asiggel/rwu-rv64iV2.0/RWU_RV/RV_NoPipeline/spec/02_prod/02_product_text14.tex

The \aschip{} implements the RISC-V \textbf{machine-mode-only} interrupt and
trap concept of the privileged specification. Both chip variants use the
same trap/CSR unit \texttt{cc\_trap\_csr} from \texttt{ip\_trapcsr/src}.
It is instantiated as \texttt{trap\_csr} in the cores \texttt{as\_cpux}
(\texttt{RV\_NoPipeline}) and \texttt{cc\_cpupipefwd}
(\texttt{RV\_PipelineCacheFwd}). The core decides \emph{when} a trap is
taken (its precise-trap point, see below); \texttt{cc\_trap\_csr} holds the
architectural state and decides \emph{what} happens.

All three standard machine interrupts are supported:
\begin{itemize}
  \item \textbf{Machine External Interrupt} (MEI, \texttt{mcause}\,=\,\texttt{0x800...B}):
    from ICU0 via \texttt{irq\_ext\_i[7]}.
  \item \textbf{Machine Software Interrupt} (MSI, \texttt{mcause}\,=\,\texttt{0x800...3}):
    CPU input \texttt{irq\_m\_soft\_i}, intended for the \texttt{msip} bit of
    a CLINT.
  \item \textbf{Machine Timer Interrupt} (MTI, \texttt{mcause}\,=\,\texttt{0x800...7}):
    CPU input \texttt{irq\_m\_timer\_i}, intended for the \texttt{mtip}
    output (\texttt{mtime}\,$\geq$\,\texttt{mtimecmp}) of a CLINT.
\end{itemize}
No CLINT exists on the chip yet; in both variants \texttt{as\_top\_mem}
ties the inputs \texttt{irq\_m\_soft\_i} and \texttt{irq\_m\_timer\_i} to 0.
A CLINT only has to drive these two level signals.

\paragraph{Peripheral-to-CPU path.}
The top level (\texttt{as\_top\_mem}) presents an 8-bit vector,
\texttt{irq\_ext\_i} (\texttt{irq\_total\_num\_ext\_c}\,=\,8), to the CPU.
Of these 8 bits, \textbf{only bit~7 is wired into the CPU's interrupt
logic}: \texttt{cc\_trap\_csr} synchronises it (like
\texttt{irq\_m\_soft\_i} and \texttt{irq\_m\_timer\_i}) through a
2-flip-flop synchroniser and shows the result as \texttt{mip.MEIP}.
Bits~\texttt{[6:0]} are declared but not consumed.
Bit~7 is driven by \textbf{ICU0} (Section~\ref{sec:icufunc01}), a
Wishbone-addressable interrupt controller that aggregates GPIO0, UART0,
and (on \texttt{RV\_PipelineCacheFwd}) QSPI0 with software-configurable
priority and per-source masking, plus 5 further source slots reserved for
future peripherals (Table~\ref{tab:asIcuSrcAssign}). GPIO0's own interrupt
chain (per-pin change detection $\rightarrow$ \texttt{IRQSS}/\texttt{IRQSM}
$\rightarrow$ single-bit \texttt{RIS[0]} $\rightarrow$ \texttt{IMSC[0]}
$\rightarrow$ \texttt{MIS[0]} $=$ \texttt{gpio\_irq\_o}) collapses all GPIO
pins onto one line before it ever reaches ICU0; see
Section~\ref{sec:gpiofunc01} for the full GPIO0 register description.

\paragraph{Machine-mode CSRs.}
Table~\ref{tab:asTrapCsr} lists the CSRs of \texttt{cc\_trap\_csr}. Every
other CSR address raises an illegal-instruction exception, as does a write
to a read-only CSR (\texttt{csr[11:10]}\,=\,\texttt{11}).
\texttt{csrrs}/\texttt{csrrc} (and the immediate forms) with
\texttt{rs1}\,=\,\texttt{x0} (\texttt{uimm}\,=\,0) only read; they do not
write the CSR. Bits that are not listed as writable are WARL: writes are
ignored and they read as the fixed value given.

\begin{table}[htbp]
\caption{Machine-mode CSRs (\texttt{cc\_trap\_csr})}
\label{tab:asTrapCsr}
\centering
{\footnotesize
\begin{tabularx}{\textwidth}{|p{1.6cm} |p{2.1cm} |p{1.5cm} |X |}
  \hline
  Addr. & Name & Reset & Function / WARL rule \\
  \hline
  \hline
  0x300 & \texttt{mstatus}   & 0x1800 & Only \texttt{MIE}[3] and \texttt{MPIE}[7] writable;
    \texttt{MPP}[12:11]\,=\,11 fixed (M-mode only). \texttt{MIE}\,=\,0 after reset. \\
  \hline
  0x301 & \texttt{misa}      & fixed & Read-only 0x8000\_0000\_0000\_0100: MXL\,=\,2 (64 bit), extension I. \\
  \hline
  0x304 & \texttt{mie}       & 0 & \texttt{MSIE}[3], \texttt{MTIE}[7], \texttt{MEIE}[11] writable. \\
  \hline
  0x305 & \texttt{mtvec}     & 0x7F00 & \texttt{BASE}[63:2]; \texttt{MODE}[0]: 0 = direct,
    1 = vectored; \texttt{MODE}[1]\,=\,0 fixed. \\
  \hline
  0x340 & \texttt{mscratch}  & 0 & 64-bit scratch register for the trap handler. \\
  \hline
  0x341 & \texttt{mepc}      & 0 & \texttt{mepc}[1:0]\,=\,0 fixed (IALIGN\,=\,32). \\
  \hline
  0x342 & \texttt{mcause}    & 0 & Interrupt bit [63] and cause code [3:0] stored (WLRL). \\
  \hline
  0x343 & \texttt{mtval}     & 0 & Faulting address or instruction, see Table~\ref{tab:asTrapCause}. \\
  \hline
  0x344 & \texttt{mip}       & 0 & Read-only levels \texttt{MSIP}[3], \texttt{MTIP}[7],
    \texttt{MEIP}[11] of the synchronised inputs. \\
  \hline
  0xB00 & \texttt{mcycle}    & 0 & Counts every core clock cycle; writable. \\
  \hline
  0xB02 & \texttt{minstret}  & 0 & Counts retired instructions (not trapping ones); writable. \\
  \hline
  0xC00\newline 0xC02 & \texttt{cycle}\newline \texttt{instret} & -- & Read-only shadows of
    \texttt{mcycle}/\texttt{minstret}. \\
  \hline
  0xF11\newline 0xF12\newline 0xF13 & \texttt{mvendorid}\newline \texttt{marchid}\newline \texttt{mimpid} & 0 & Read-only. \\
  \hline
  0xF14 & \texttt{mhartid}   & param. & Read-only; core parameter \texttt{HART\_ID}
    (default 0). \\
  \hline
  0xF15 & \texttt{mconfigptr} & 0 & Read-only. \\
  \hline
\end{tabularx}}
\end{table}

\paragraph{Taking an interrupt.}
\begin{itemize}
  \item An interrupt is \emph{pending and enabled} when
    \texttt{mip}\,\&\,\texttt{mie}\,$\neq$\,0, and it is taken only if
    \texttt{mstatus.MIE}\,=\,1.
  \item If several are pending, the priority is MEI $>$ MSI $>$ MTI.
  \item All three are level-sensitive: \texttt{mip} follows the input
    lines and cannot be changed by software. The handler must remove the
    cause at its source (ICU0\_ICR and the peripheral's clear register;
    CLINT \texttt{msip}/\texttt{mtimecmp}) before \texttt{mret}, or the
    interrupt is taken again immediately.
  \item Target address: \texttt{mtvec.BASE} in direct mode; in vectored mode
    \texttt{BASE}\,+\,4\,$\times$\,cause for interrupts (MSI: +0x0C,
    MTI: +0x1C, MEI: +0x2C) and \texttt{BASE} for exceptions.
\end{itemize}

\paragraph{Precise traps.}
A trap is \emph{precise}: \texttt{mepc} points to an instruction such that
every older instruction has completed and neither this instruction nor any
younger one has changed a register, a CSR or memory.
\begin{itemize}
  \item An \textbf{exception} is taken on the faulting instruction:
    \texttt{mepc} = its own address. The instruction is suppressed: no
    register write, no CSR write, and a load/store does \emph{not} access
    memory.
  \item An \textbf{interrupt} is taken between two instructions:
    \texttt{mepc} = address of the first instruction that has not been
    executed (also directly after a taken branch or jump: then it is the
    branch target).
  \item \texttt{RV\_NoPipeline}: exceptions are detected in
    \texttt{EXEC\_ST}/\texttt{EXECLD\_ST}; the store write enable and the
    register write are suppressed. Interrupts, exceptions and
    \texttt{mret} redirect the fetch in the following \texttt{FETCH0\_ST},
    before the next instruction is fetched, so no wrong-path instruction
    ever enters IR. The address of the next instruction in program order is
    registered at commit (\texttt{npc\_r}).
  \item \texttt{RV\_PipelineCacheFwd}: misaligned loads/stores and
    misaligned branch/jump targets are detected in EX and, like illegal
    instructions and I-/D-cache faults, carried as flags to WB, where the
    trap is taken. A load/store with an exception sends no
    \texttt{dc\_req}, and no younger instruction in MEM sends
    \texttt{dc\_req} in the cycle WB traps or returns. An interrupt is
    taken on the instruction in WB before it commits (it is squashed,
    \texttt{mepc} = its address), except for a load/store, whose memory
    access in MEM has already happened: it commits, and the interrupt is
    taken on the next instruction that reaches WB.
\end{itemize}

\paragraph{Trap entry and return.}
On trap entry \texttt{mepc} $\leftarrow$ trap PC, \texttt{mcause} and
\texttt{mtval} $\leftarrow$ Table~\ref{tab:asTrapCause},
\texttt{mstatus.MPIE} $\leftarrow$ \texttt{mstatus.MIE},
\texttt{mstatus.MIE} $\leftarrow$ 0, PC $\leftarrow$ trap target.
\texttt{mret} sets PC $\leftarrow$ \texttt{mepc},
\texttt{mstatus.MIE} $\leftarrow$ \texttt{mstatus.MPIE},
\texttt{mstatus.MPIE} $\leftarrow$ 1. A handler that saves \texttt{mepc}
and \texttt{mcause} (e.g.\ via \texttt{mscratch}) may set
\texttt{mstatus.MIE} again to allow nested interrupts.

\begin{table}[htbp]
\caption{Trap causes}
\label{tab:asTrapCause}
\centering
{\footnotesize
\begin{tabularx}{\textwidth}{|l |X |X |}
  \hline
  \texttt{mcause} & Cause & \texttt{mtval} \\
  \hline
  \hline
  0 & Instruction address misaligned (taken branch/jump to an address with
      bit 1 set; JALR clears bit 0 first) & target address \\
  \hline
  1 & Instruction access fault (I-cache AXI4 error, \texttt{RV\_PipelineCacheFwd}) & fetch address \\
  \hline
  2 & Illegal instruction (decoder, unknown CSR, write to read-only CSR,
      reserved \texttt{SYSTEM} encoding) & instruction bits \\
  \hline
  3 & Breakpoint (\texttt{ebreak}) & 0 \\
  \hline
  4 / 6 & Load / store address misaligned & access address \\
  \hline
  5 & Load access fault (D-cache AXI4 error, \texttt{RV\_PipelineCacheFwd}) & access address \\
  \hline
  11 & Environment call from M-mode (\texttt{ecall}) & 0 \\
  \hline
  \hline
  0x800\ldots3 / 7 / B & Machine software / timer / external interrupt & 0 \\
  \hline
\end{tabularx}}
\end{table}

\texttt{ecall} and \texttt{ebreak} have no side effect beyond the trap;
\texttt{mepc} points at the instruction itself, so the handler has to add 4
before \texttt{mret} to continue after it.

\paragraph{WFI.}
In \texttt{RV\_NoPipeline}, \texttt{wfi} stays in \texttt{EXEC\_ST} until an
interrupt is pending and enabled in \texttt{mie} (independent of
\texttt{mstatus.MIE}); then it completes, and if \texttt{mstatus.MIE}\,=\,1
the interrupt is taken with \texttt{mepc} = address after \texttt{wfi}.
In \texttt{RV\_PipelineCacheFwd}, \texttt{wfi} is executed as a NOP, which
the privileged specification allows.

\paragraph{Verification.}
\texttt{ip\_trapcsr/tb/cc\_trap\_csr\_tb.sv} checks the unit alone (reset
values, legality, WARL, priority, vectoring, counters).
\texttt{cocotb/test\_traps.py} of both variants (shared bodies in
\texttt{RV\_NoPipeline/cocotb/trap\_tests.py}) interrupts programs at random
points and checks that no instruction is lost or repeated (also around
jumps and memory read-modify-write sequences) and that every \texttt{mepc}
is the first unexecuted instruction; it also checks every exception cause,
\texttt{mtval}, the suppression of the trapping instruction, vectored
\texttt{mtvec} and \texttt{wfi}.

\paragraph{Open items.}
\begin{itemize}
  \item A CLINT (\texttt{mtime}, \texttt{mtimecmp}, \texttt{msip}) is not
    yet on the chip; the CPU inputs are ready for it. The \texttt{time}
    CSR (0xC01) is not implemented and traps as illegal.
  \item \texttt{mcountinhibit} is not implemented (illegal).
  \item ICU0 provisions 8 source slots but only 3 are wired to real
    hardware (GPIO0, UART0, and -- \texttt{RV\_PipelineCacheFwd} only --
    QSPI0); connecting a future interrupt-capable peripheral only requires
    wiring it into one of the 5 remaining slots
    (Table~\ref{tab:asIcuSrcAssign}). All ICU0 sources share MEI
    (cause 11), so per-source dispatch uses ICU0\_IRQID in software.
\end{itemize}
