asiggel/rwu-rv64iV2.0/RWU_RV/RV_NoPipeline/spec/05_gpio/05_gpio_tab06.tex

Table \ref{tab:asGpioPer06} shows the input and outputs of the GPIO Top.
\begin{table}[H]
\caption{GPIO Top I/O}
\label{tab:asGpioPer06}
\centering
\begin{tabularx}{\textwidth}{|l |l |l |X|}
  \hline
  Pin & Direction & Width & Explanation \\
  \hline
  \hline
  clk\_i & in & 1 & System clock \\
  \hline
  rst\_i & in & 1 & System reset. Active high. \\
  \hline
  wbdAddr\_i(3:0) & in & 4 &  From WB-Bus. Peripherals addresses. \\
  \hline
  wbdDat\_i(63:0) & in & 64 &  From WB-Bus. Peripherals data input. \\
  \hline
  wbdDat\_o(63:0) & out & 64 &  To WB-Bus. Peripherals data output. \\
  \hline
  wbdWe\_i & in & 1 &  From WB-Bus. Peripherals write enable. \\
  \hline
  wbdSel\_i(7:0) & in & 8 &  From WB-Bus. Peripherals byte select. \\
  \hline
  wbdStb\_i & in & 1 &  From WB-Bus. Valid bus cycle.  \\
  \hline
  wbdAck\_o & out & 1 &  To WB-Bus. Error free bus transaction.  \\
  \hline
  wbdCyc\_i & in & 1 &  From WB-Bus. High for complete bus cycle.  \\
  \hline
  gpio\_irq\_o & out & 1 &  GPIO interrupt. \\
  \hline
  gpio\_o(7:0) & out & 8 &  To chip pins. GPIO outputs for one block. \\
  \hline
  cs\_o & out & 1 &  To chip pins. Chip select for outside GPIO blocks.   \\
  \hline
\end{tabularx}
\end{table}

Table \ref{tab:asGpioPer06a} shows the internals  of the GPIO Top.
\begin{table}[H]
\caption{GPIO Top Signals}
\label{tab:asGpioPer06a}
\centering
\begin{tabularx}{\textwidth}{|l |l |X|}
  \hline
  Signal & Width & Explanation \\
  \hline
  \hline
  irq\_s  & 8 & One-clock-cycle pulses from the GPIO kernel, one per pin (edge detected). Connected to irq\_same\_i of gpioIrq. \\
  \hline
  gpioIrq & -- & Instance of the shared interrupt register block \texttt{as\_irq\_peripheral} (\texttt{ip\_irqper}) with irqs\_yes\_no\,=\,1, nr\_same\_irqs\,=\,8, nr\_other\_irqs\,=\,1 (input tied to 0). It implements all interrupt registers below, see Section ``Interrupt Registers''. \\
  \hline
  irq\_dataob\_s  & 64 & Read data of gpioIrq. Selected by the read multiplexer for all addresses not belonging to ID, DIR or DATA. \\
  \hline
  \asgpioIRQSSRegInt  & 64 & GPIO Interrupt Request Source Status Register \asgpioIRQSSRegExt. Sticky: irqss\_r\,$\leftarrow$\,(irqss\_r \& \textasciitilde clear) | irq\_s. A new pulse is never lost; bits are cleared individually via \asgpioIRQSCRegExt. \\
  \hline
  \asgpioIRQSCRegInt  & 1 & Write strobe of the GPIO Interrupt Request Source Clear Register \asgpioIRQSCRegExt. Not stored: in the write cycle every bit written as '1' clears the corresponding \asgpioIRQSSRegExt bit; 0 - No change. Reading returns 0. \\
  \hline
  \asgpioIRQSMRegInt  & 64 & GPIO Interrupt Request Source Mask Register \asgpioIRQSMRegExt.  One interrupt request source mask bit is provided for
each interrupt request source: 0 - Interrupt Request Source Disabled, 1 - Interrupt Request Source Enabled. \\
  \hline
  irq\_same\_comb\_s  & 1 & |(\asgpioIRQSSRegInt \& \asgpioIRQSMRegInt): OR of all unmasked pending pin interrupts. Drives RIS[0] as a level. \\
  \hline
  \asgpioRISRegInt  & 64 & GPIO Raw Interrupt Status \asgpioRISRegExt = ris\_r | irq\_same\_comb\_s (bit 0). ris\_r is sticky, set by \asgpioISRRegExt, cleared by \asgpioICRRegExt. 0 - No Interrupt, 1 - Interrupt Pending. \\
  \hline
  \asgpioISRRegInt  & 1 & Write strobe of the GPIO Interrupt Set Register \asgpioISRRegExt. Not stored: writing a '1' sets the corresponding \asgpioRISRegExt bit (and MIS if IMSC = 1).  0 - No change. Reading returns 0. \\
  \hline
  \asgpioICRRegInt  & 1 & Write strobe of the GPIO Interrupt Clear Register \asgpioICRRegExt. Not stored: writing a '1' clears the corresponding ISR-forced \asgpioRISRegExt bit.  0 - No change. Reading returns 0. \\
  \hline
  \asgpioIMSCRegInt  & 64 & GPIO Interrupt Mask Control Register \asgpioIMSCRegExt. One interrupt mask bit is provided for each service request: 0 - Interrupt Disabled, 1 - Interrupt Enabled. \\
  \hline
  \asgpioMISRegInt  & 64 & GPIO Masked Interrupt Status \asgpioMISRegExt = \asgpioRISRegExt \& \asgpioIMSCRegExt (combinatorial). gpio\_irq\_o = |\asgpioMISRegExt. \\
  \hline
  \asgpioIDRegInt  & 64 & GPIO ID Register \asgpioIDRegExt. \\
  \hline
  \asgpioDirRegInt  & 64 & GPIO Direction Register \asgpioDirRegExt. \\
  \hline
  \asgpioDatRegInt  & 64 & GPIO Data Register \asgpioDatRegExt. If the direction is input, the values from the pad will be written to the register. If the direction is output, the values from the bus will be written to the register. \\
  \hline
\end{tabularx}
\end{table}
