asiggel/rwu-rv64iV2.0/RWU_RV/RV_NoPipeline/spec/05_imem/05_imem_tab06.tex

% Placeholder for the I-Mem Top I/O table (not included, see 00_rwurv64i_all.tex).
% The former content was a stale copy of the GPIO Top tables; the current GPIO
% description is in 05_gpio/05_gpio_tab06.tex.
