asiggel/rwu-rv64iV2.0/RWU_RV/RV_NoPipeline/spec/00_rwurv64i_top.tex

%%%%%%%%%%%%%%%%%%%%%%%%%%%%%%%%%%%%%%%%%%
% Englisch
%%%%%%%%%%%%%%%%%%%%%%%%%%%%%%%%%%%%%%%%%%
\documentclass[a4paper,12pt]{book}
\usepackage[english]{babel}
\selectlanguage{english}
%%%%%%%%%%%%%%%%%%%%%%%%%%%%%%%%%%%%%%%%%%
% Deutsch
%%%%%%%%%%%%%%%%%%%%%%%%%%%%%%%%%%%%%%%%%%
%\documentclass[a4paper,12pt]{book} 
%\usepackage[german,ngerman]{babel} %Chapter -> Kapitel
%\usepackage[T1]{fontenc}           %Umlaute
%\selectlanguage{ngerman}
%%%%%%%%%%%%%%%%%%%%%%%%%%%%%%%%%%%%%%%%%%

%%%%%%%%%%%%%%%%%%%%%%%%%%%%%%%%%%%%%%%%%%
% Pfade %%%%%%%%%%%%%%%%%%%%%%%%%%%%%%%%%%
%\newcommand{\ASROOT}{/media/andreas/arbeit/neuestruktur/hs_vorlesungen/}
%\newcommand{\UMGEBUNG}{\ASROOT latex/}
\newcommand{\UMGEBUNG}{./}
\newcommand{\BILDERa}{./}
\newcommand{\TEXTa}{./}
\newcommand{\TEXTprod}{./02_prod/}
\newcommand{\TEXTarch}{./03_arch/}
\newcommand{\TEXTalu}{./04_alu/}
\newcommand{\TEXTdec}{./04_dec/}
\newcommand{\TEXTmems}{./04_memsyst/}
\newcommand{\TEXTgpio}{./05_gpio/}
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
\newcommand{\asgpioIDRegExt}{\textbf{GPIO0\_ID}\,}

% CGU
\newcommand{\ascguIDRegInt}{id\_reg\_s\,}
\newcommand{\ascguIDRegExt}{\textbf{CGU\_ID}\,}

% QSPI
\newcommand{\asqspiCtrlRegInt}{ctrl\_reg\_s }
\newcommand{\asqspiCtrlRegExt}{\textbf{QSPI0\_CTRL}\,}
\newcommand{\asqspiCmdRegInt}{cmd\_reg\_s\,}
\newcommand{\asqspiCmdRegExt}{\textbf{QSPI0\_CMD}\,}
\newcommand{\asqspiAddrRegInt}{addr\_reg\_s\,}
\newcommand{\asqspiAddrRegExt}{\textbf{QSPI0\_ADDR}\,}
\newcommand{\asqspiLenRegInt}{len\_reg\_s\,}
\newcommand{\asqspiLenRegExt}{\textbf{QSPI0\_LEN}\,}
\newcommand{\asqspiDummyRegInt}{dummy\_reg\_s\,}
\newcommand{\asqspiDummyRegExt}{\textbf{QSPI0\_DUMMY}\,}
\newcommand{\asqspiStatusRegInt}{status\_reg\_s\,}
\newcommand{\asqspiStatusRegExt}{\textbf{QSPI0\_STATUS}\,}
\newcommand{\asqspiTxdataRegInt}{txdata\_reg\_s\,}
\newcommand{\asqspiTxdataRegExt}{\textbf{QSPI0\_TXDATA}\,}
\newcommand{\asqspiRxdataRegInt}{rxdata\_reg\_s\,}
\newcommand{\asqspiRxdataRegExt}{\textbf{QSPI0\_RXDATA}\,}
\newcommand{\asqspiFifostatRegInt}{fifostat\_reg\_s\,}
\newcommand{\asqspiFifostatRegExt}{\textbf{QSPI0\_FIFOSTAT}\,}
\newcommand{\asqspiICRRegInt}{icr\_reg\_s\,}
\newcommand{\asqspiICRRegExt}{\textbf{QSPI0\_ICR}\,}
\newcommand{\asqspiRISRegInt}{ris\_reg\_s\,}
\newcommand{\asqspiRISRegExt}{\textbf{QSPI0\_RIS}\,}
\newcommand{\asqspiISRRegInt}{isr\_reg\_s\,}
\newcommand{\asqspiISRRegExt}{\textbf{QSPI0\_ISR}\,}
\newcommand{\asqspiIMSCRegInt}{imsc\_reg\_s\,}
\newcommand{\asqspiIMSCRegExt}{\textbf{QSPI0\_IMSC}\,}
\newcommand{\asqspiMISRegInt}{mis\_reg\_s\,}
\newcommand{\asqspiMISRegExt}{\textbf{QSPI0\_MIS}\,}
\newcommand{\asqspiIDRegInt}{id\_reg\_s\,}
\newcommand{\asqspiIDRegExt}{\textbf{QSPI0\_ID}\,}
\newcommand{\asqspiClkdivRegInt}{clkdiv\_reg\_s\,}
\newcommand{\asqspiClkdivRegExt}{\textbf{QSPI0\_CLKDIV}\,}
\newcommand{\asqspiTimeoutRegInt}{timeout\_reg\_s\,}
\newcommand{\asqspiTimeoutRegExt}{\textbf{QSPI0\_TIMEOUT}\,}
\newcommand{\asqspiFifostatusRegInt}{fifostat\_reg\_s\,}
\newcommand{\asqspiFifostatusRegExt}{\textbf{QSPI0\_FIFOSTAT}\,}
\newcommand{\asqspiXipRegInt}{xipmode\_reg\_s\,}
\newcommand{\asqspiXipRegExt}{\textbf{QSPI0\_XIPMODE}\,}
\newcommand{\asqspiStatusxRegInt}{status\_reg\_s\,}
\newcommand{\asqspiStatusxRegExt}{\textbf{QSPI0\_STATUS}\,}

% QSPI IRQ signal name (for memory-map IRQ table)
\newcommand{\asqspiIRQ}{qspi\_irq\_o\,}

% UART
\newcommand{\asuartTx}{uart0\_tx\_o\,}
\newcommand{\asuartRx}{uart0\_rx\_i\,}
\newcommand{\asuartIRQ}{UART0\_INT\,}
\newcommand{\asuartIDRegInt}{id\_reg\_s\,}
\newcommand{\asuartIDRegExt}{\textbf{UART0\_ID}\,}
\newcommand{\asuartLcrRegInt}{lcr\_reg\_s\,}
\newcommand{\asuartLcrRegExt}{\textbf{UART0\_LCR}\,}
\newcommand{\asuartClkdivRegInt}{clkdiv\_reg\_s\,}
\newcommand{\asuartClkdivRegExt}{\textbf{UART0\_CLKDIV}\,}
\newcommand{\asuartCtrlRegInt}{ctrl\_reg\_s\,}
\newcommand{\asuartCtrlRegExt}{\textbf{UART0\_CTRL}\,}
\newcommand{\asuartStatusRegInt}{status\_reg\_s\,}
\newcommand{\asuartStatusRegExt}{\textbf{UART0\_STATUS}\,}
\newcommand{\asuartDataRegInt}{data\_reg\_s\,}
\newcommand{\asuartDataRegExt}{\textbf{UART0\_DATA}\,}
\newcommand{\asuartFifostatRegInt}{fifostat\_reg\_s\,}
\newcommand{\asuartFifostatRegExt}{\textbf{UART0\_FIFOSTAT}\,}
\newcommand{\asuartRxthresRegInt}{rxthres\_reg\_s\,}
\newcommand{\asuartRxthresRegExt}{\textbf{UART0\_RXTHRES}\,}
\newcommand{\asuartRISRegInt}{u\_irq.ris\_s\,}
\newcommand{\asuartRISRegExt}{\textbf{UART0\_RIS}\,}
\newcommand{\asuartIMSCRegInt}{u\_irq.imsc\_r\,}
\newcommand{\asuartIMSCRegExt}{\textbf{UART0\_IMSC}\,}
\newcommand{\asuartMISRegInt}{u\_irq.mis\_s\,}
\newcommand{\asuartMISRegExt}{\textbf{UART0\_MIS}\,}
\newcommand{\asuartICRRegInt}{u\_irq.wr\_icr\_s\,}
\newcommand{\asuartICRRegExt}{\textbf{UART0\_ICR}\,}
\newcommand{\asuartISRRegInt}{u\_irq.wr\_isr\_s\,}
\newcommand{\asuartISRRegExt}{\textbf{UART0\_ISR}\,}

\usepackage{tikz}
\usetikzlibrary{shapes.arrows}
\usetikzlibrary{shapes.multipart}
\usetikzlibrary{positioning}
\usetikzlibrary{automata}

\begin{document}
%%%%%%%%%%%%%%%%%%%%%%%%%%%%%%%%%%%%%%%%%%
% Titel, author, date
%%%%%%%%%%%%%%%%%%%%%%%%%%%%%%%%%%%%%%%%%%
\ifthenelse{\equal{\deutsch}{false}}
{\title{Specification - \aschip}}
{\title{Spezifikation - \aschip}}
\author{Prof. Dr.-Ing. A. Siggelkow}
\date{\today}
%%%%%%%%%%%%%%%%%%%%%%%%%%%%%%%%%%%%%%%%%%
% Titelpage and table of content
%%%%%%%%%%%%%%%%%%%%%%%%%%%%%%%%%%%%%%%%%%
\pagenumbering{Alph}
\begin{titlepage}
  \maketitle
  \thispagestyle{empty}
\end{titlepage}
\pagenumbering{arabic}
%\tableofcontents
\thispagestyle{empty}
\newpage
%%%%%%%%%%%%%%%%%%%%%%%%%%%%%%%%%%%%%%%%%%
% Set the chapter counter and relate the
% equation numbers to the chapters
%%%%%%%%%%%%%%%%%%%%%%%%%%%%%%%%%%%%%%%%%%
\setcounter{chapter}{0}
\numberwithin{equation}{section}
%%%%%%%%%%%%%%%%%%%%%%%%%%%%%%%%%%%%%%%%%%
% Document
%%%%%%%%%%%%%%%%%%%%%%%%%%%%%%%%%%%%%%%%%%
%\input{\TEXTa 2do.tex}
\input{\TEXTa 00_rwurv64i_all}
\printbibliography
\end{document}
