asiggel/rwu-rv64iV2.0/RWU_RV/RV_NoPipeline/spec/06_mcnn/06_mcnn_all.tex

% Variant C -- Multi-Core NN Inference (architecture concept)
\label{ch:mcnn}

%=============================================================
% History
%=============================================================
\section{History}

\begin{table}[H]
\caption{History}
\label{tab:mcnnhistory01}
\centering
\begin{tabularx}{\textwidth}{|X |X |X |}
  \hline
  \multicolumn{3}{|l|}{History} \\
  \hline
  \multicolumn{1}{|l}{Target Spec.} & \multicolumn{1}{l}{Current version : 0.1, 2026-11-06} & \multicolumn{1}{l|}{Author: A. Siggelkow}\\
  \multicolumn{1}{|l}{ } & \multicolumn{1}{l}{Previous version : ---} & \multicolumn{1}{l|}{ }\\
  \hline
  \hline
  Paragraph (in previous version) & Paragraph (in current version) / date & Subjects (major changes since last revision) \\
  \hline
  \hline
  \multicolumn{3}{|l|}{Current Chapter Version: C0.1; Date: 2026-11-06} \\
  \hline
  & \ref{ch:mcnn} / 2026-11-06 & First draft of the architecture concept for Variant~C (AS, Claude) \\
  \hline
\end{tabularx}
\end{table}
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
