asiggel/rwu-rv64iV2.0/RWU_RV/RV_NoPipeline/project.jpg

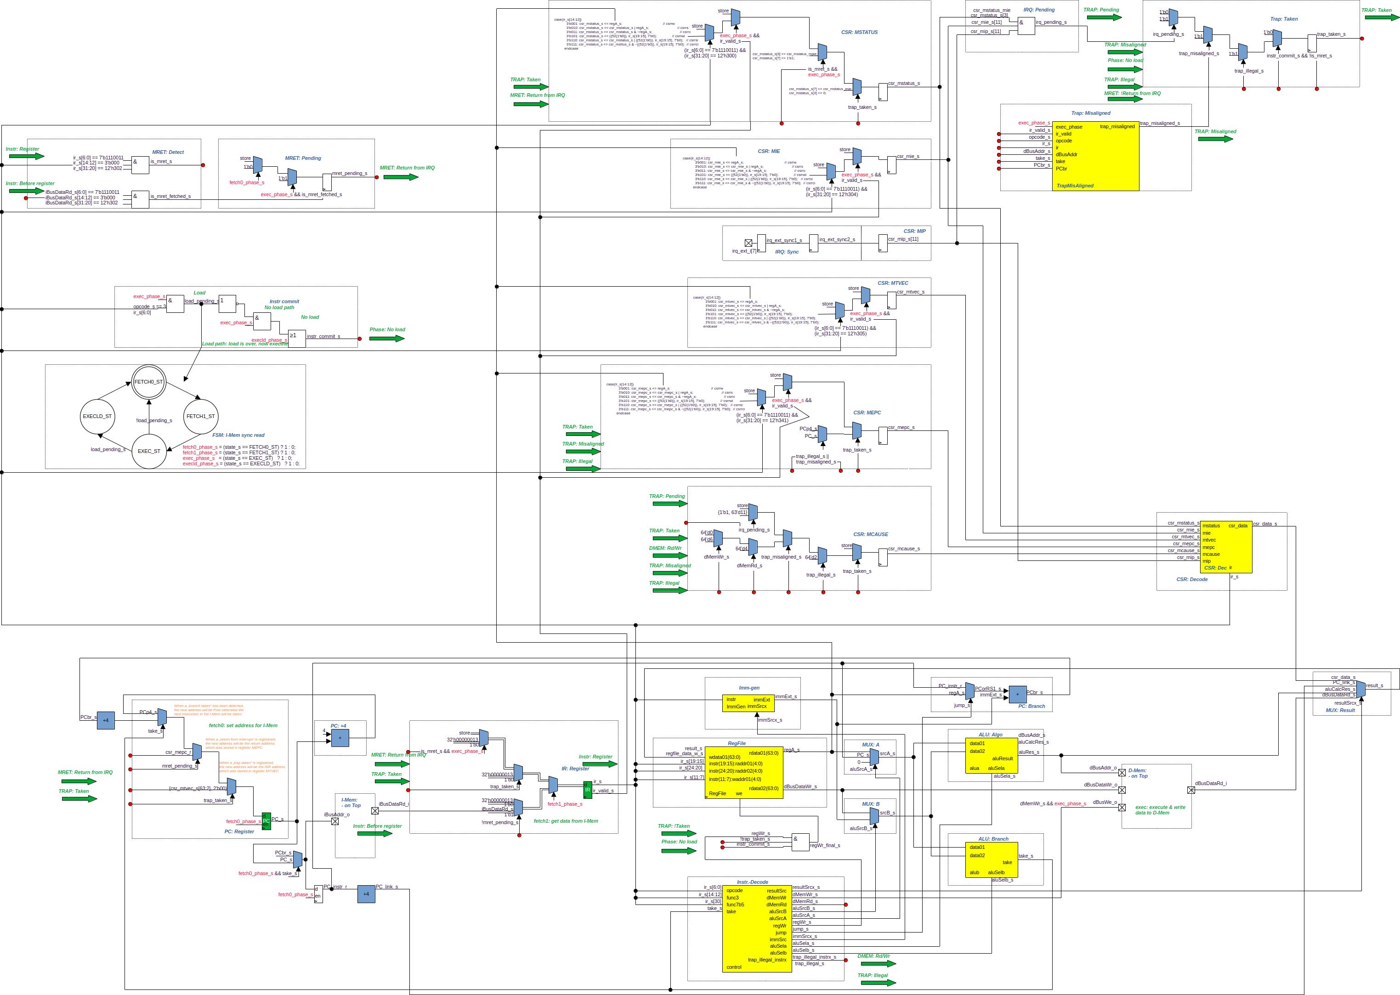
RWU_RV/RV_NoPipeline/project.jpg
