asiggel/rwu-rv64iV2.0/RWU_RV/RV_NoPipeline/spec/tikz_tutorial.pdf

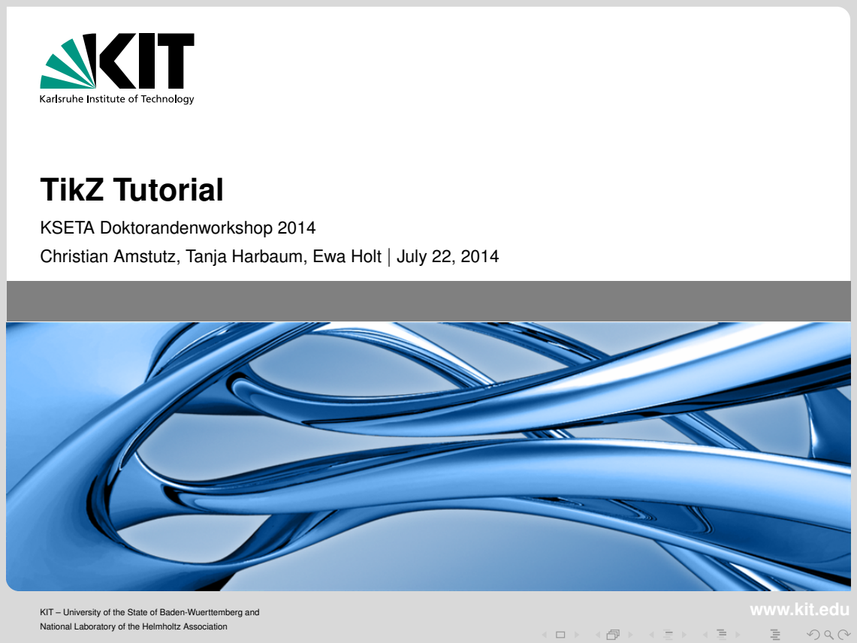
[picture p17: page 1]
TikZ Tutorial

KSETA Doktorandenworkshop 2014
Christian Amstutz, Tanja Harbaum, Ewa Holt | July 22, 2014

KIT – University of the State of Baden-Wuerttemberg and
National Laboratory of the Helmholtz Association

www.kit.edu

# Outline

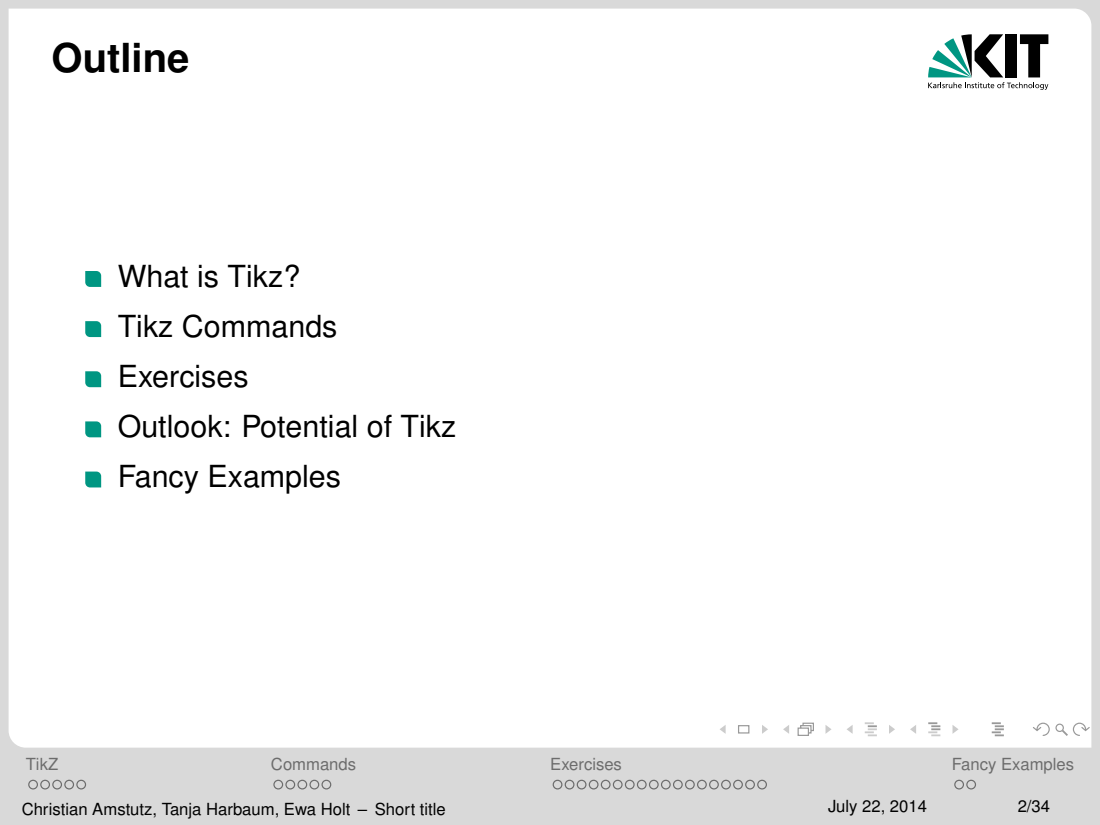
[picture p18: page 2]
TikZ; Commands; Exercises; Fancy Examples; Christian Amstutz, Tanja Harbaum, Ewa Holt – Short title; July 22, 2014

What is Tikz?
Tikz Commands
Exercises
Outlook: Potential of Tikz
Fancy Examples

# What is TikZ?

## Language for creating vector graphics in LATEX

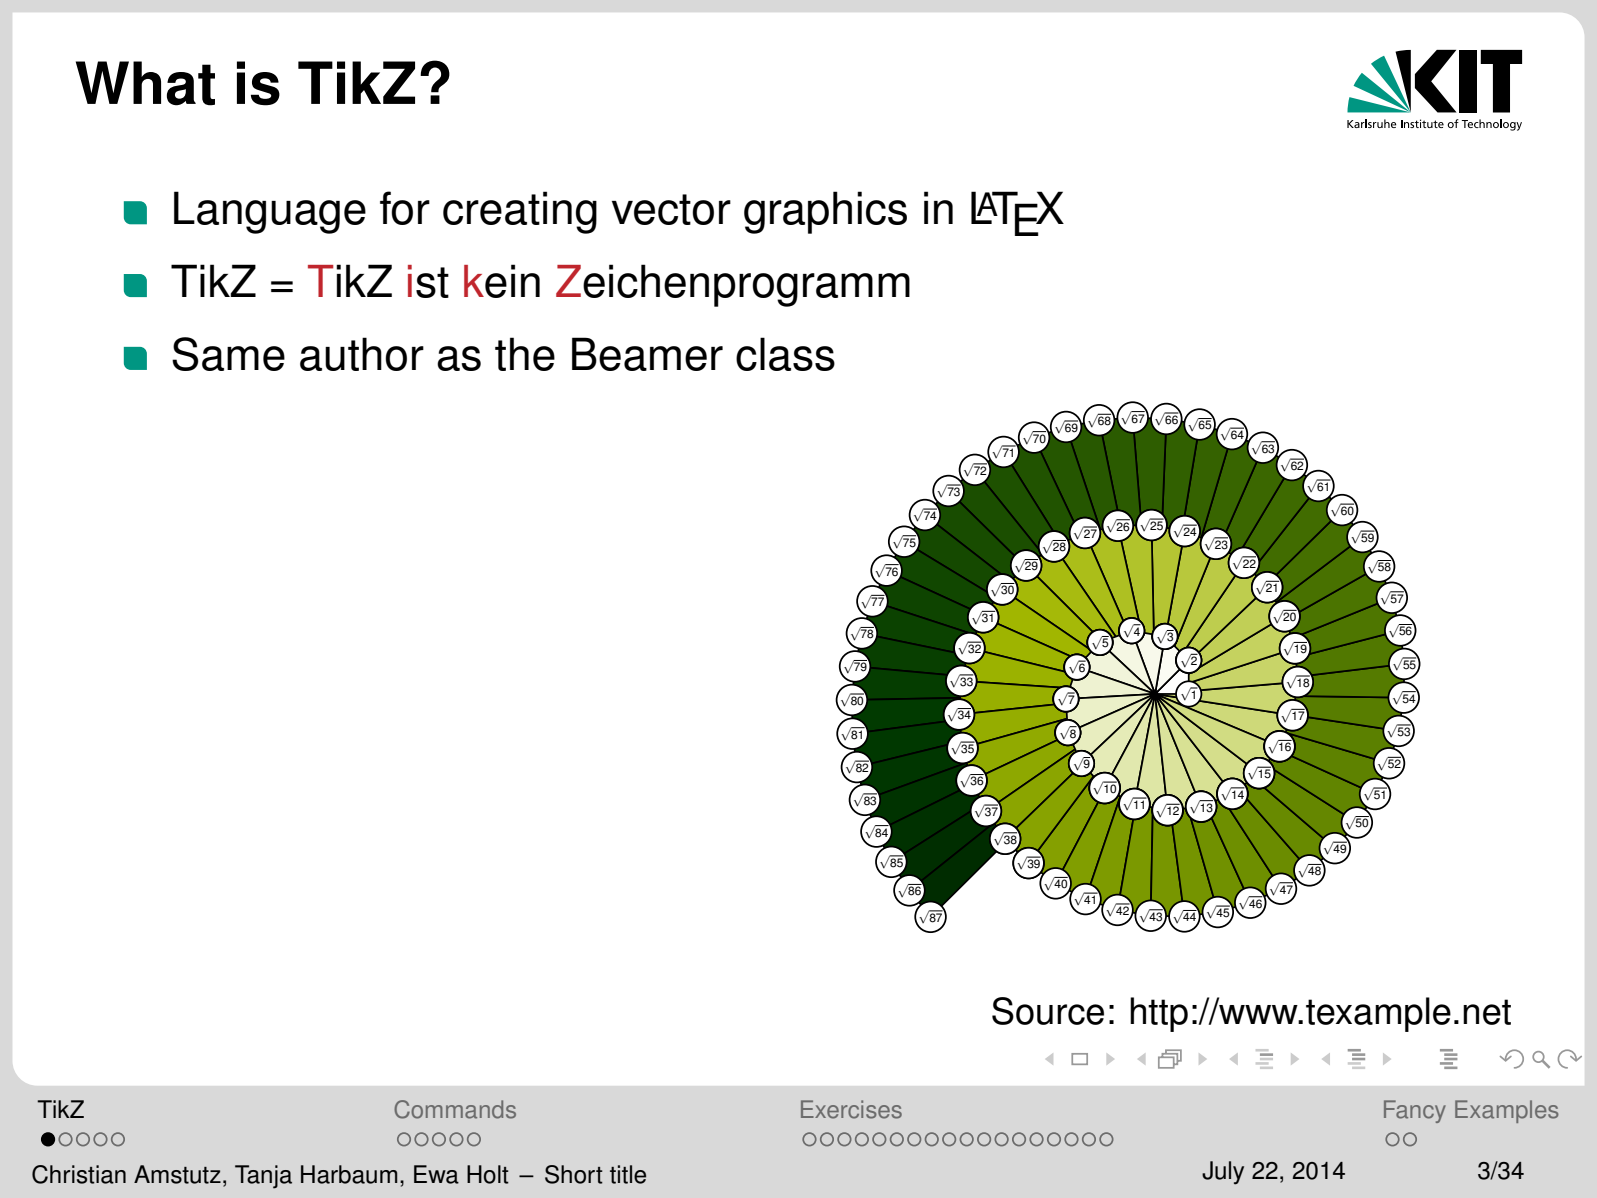
[picture p19: page 3]
Christian Amstutz, Tanja Harbaum, Ewa Holt – Short title; July 22, 2014

TikZ = TikZ ist kein Zeichenprogramm
Same author as the Beamer class

Source: http://www.texample.net

# Why using TikZ?

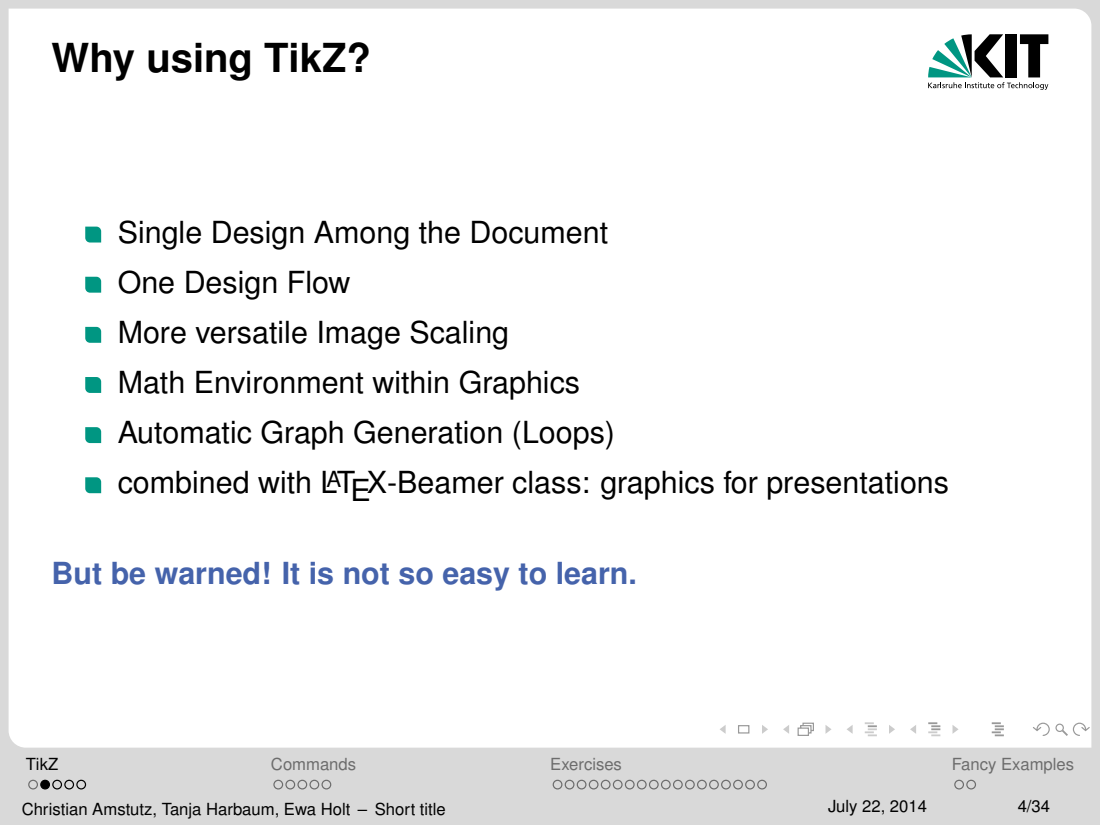
[picture p20: page 4]
Christian Amstutz, Tanja Harbaum, Ewa Holt – Short title; July 22, 2014

Single Design Among the Document
One Design Flow
More versatile Image Scaling
Math Environment within Graphics
Automatic Graph Generation (Loops)
combined with LATEX-Beamer class: graphics for presentations

But be warned! It is not so easy to learn.

# Scaling Effects

Raster Graphic (JPG) Vector Graphic (PDF) | TikZ

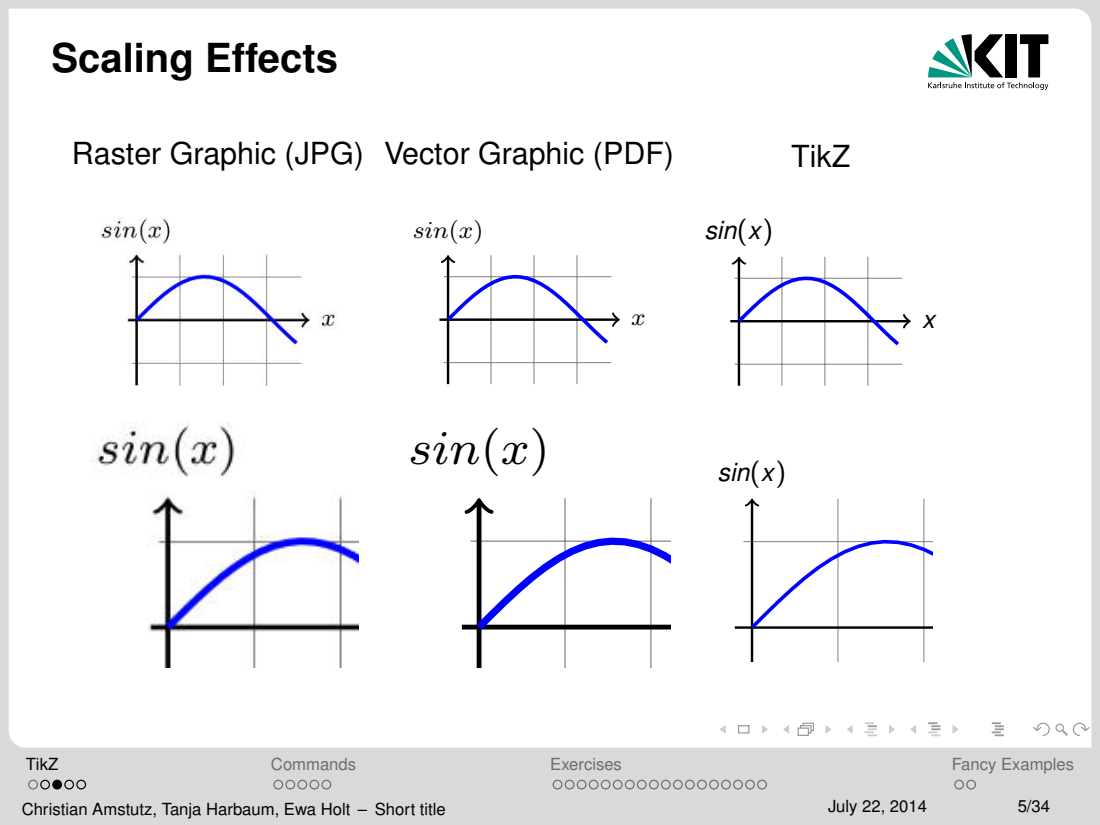
[picture p21: page 5]
sin(x); Christian Amstutz, Tanja Harbaum, Ewa Holt – Short title; July 22, 2014

# Math Environment

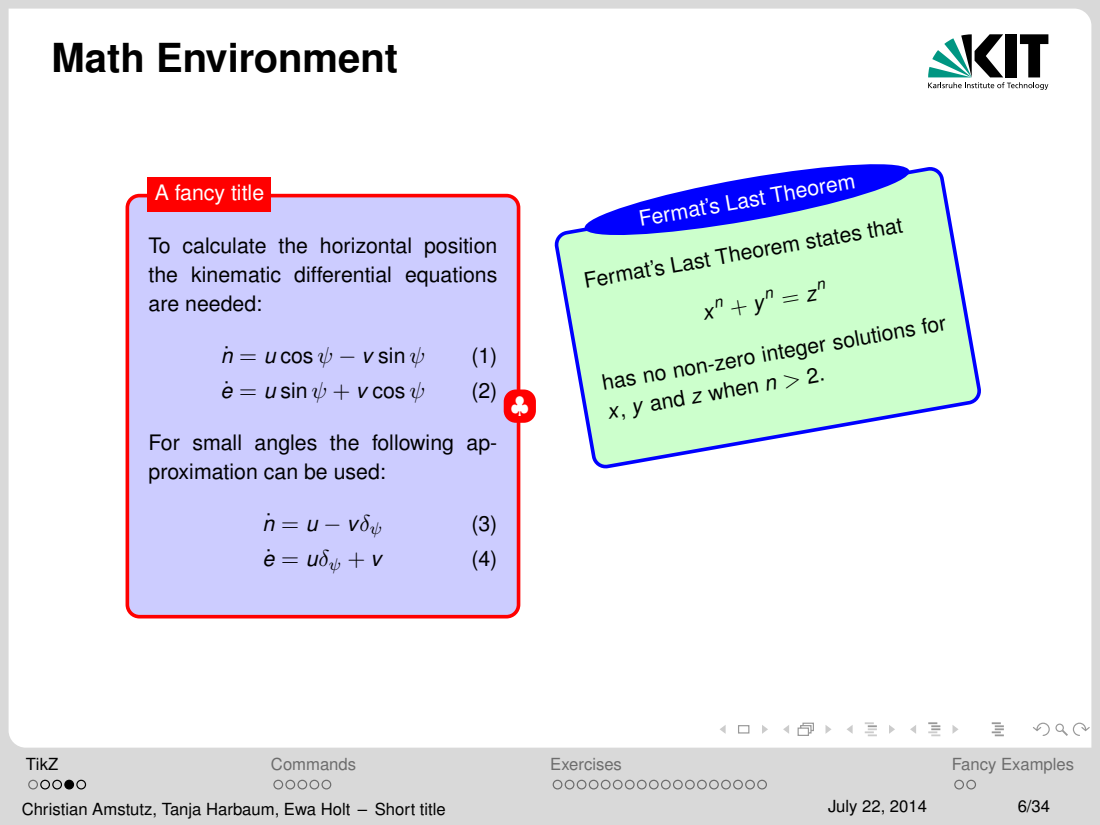
[picture p22: page 6]
n˙ = u cos ψ − v sin ψ; e˙ = u sin ψ + v cos ψ; n˙ = u − vδψ; e˙ = uδψ + v; A fancy title; x, y and z when n > 2.; Christian Amstutz, Tanja Harbaum, Ewa Holt – Short title; July 22, 2014

Fermat’s Last Theorem

Fermat’s Last Theorem states that

To calculate the horizontal position
the kinematic differential equations
are needed:

has no non-zero integer solutions for

For small angles the following ap-
proximation can be used:

# Loops

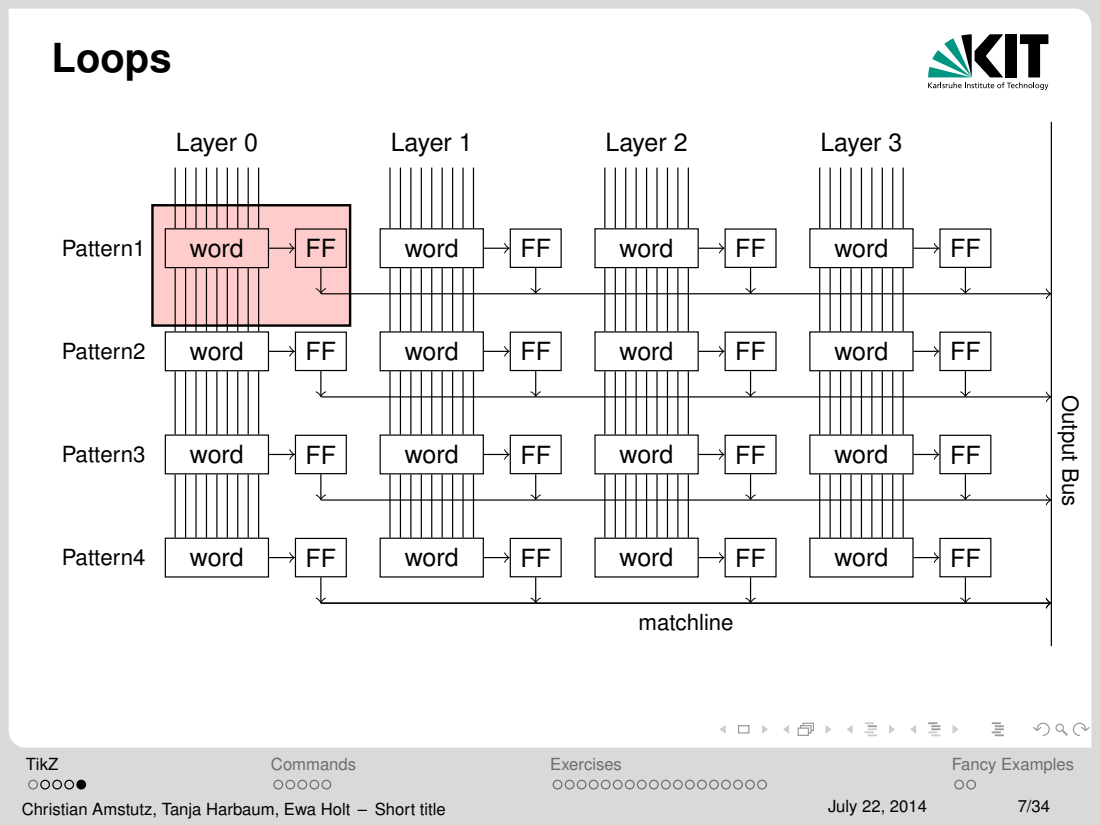
[picture p23: page 7]
Layer 0; Layer 1; Layer 2; Layer 3; Pattern1; word; Pattern2; Pattern3; Pattern4; matchline; Output Bus; Christian Amstutz, Tanja Harbaum, Ewa Holt – Short title; July 22, 2014

# Setting up the Environment in LATEX

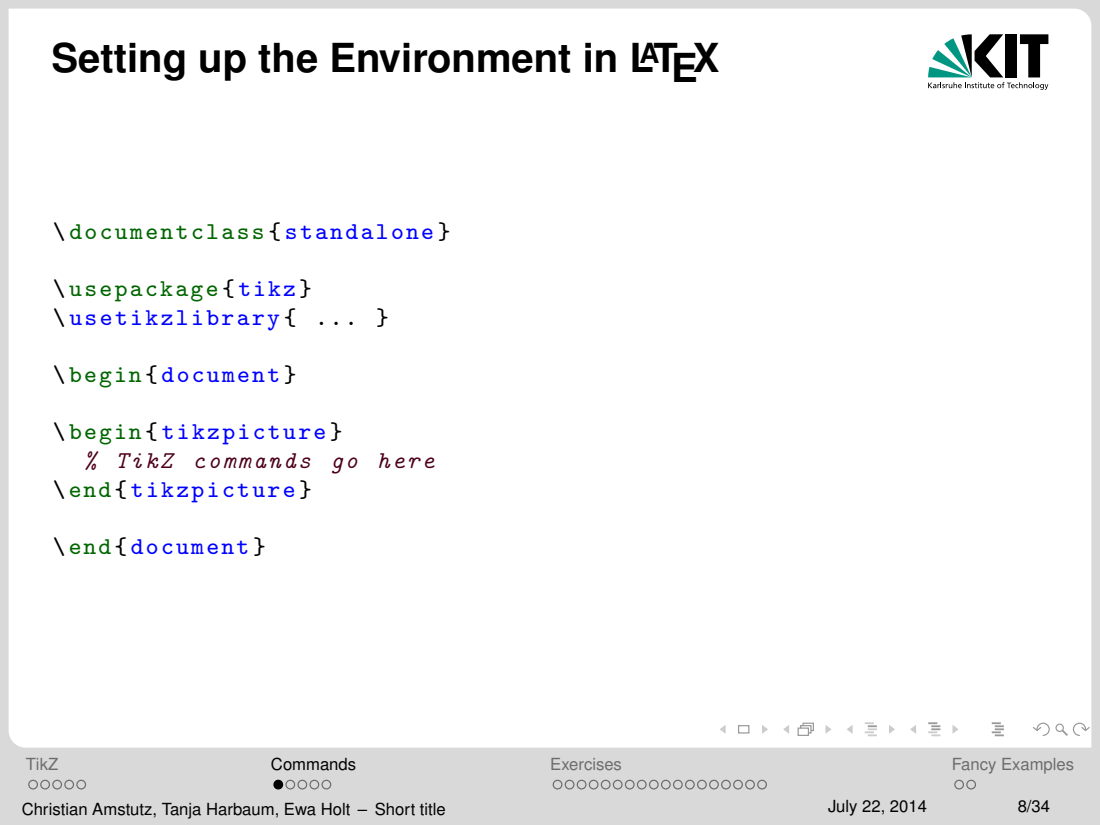
[picture p24: page 8]
\ documentclass { standalone }; \ usepackage { tikz } \ usetikzlibrary { ... }; \ begin { document }; \ end { document }; Christian Amstutz, Tanja Harbaum, Ewa Holt – Short title; July 22, 2014

\ begin { tikzpicture }
% TikZ commands go here
\ end { tikzpicture }

# The \draw Command

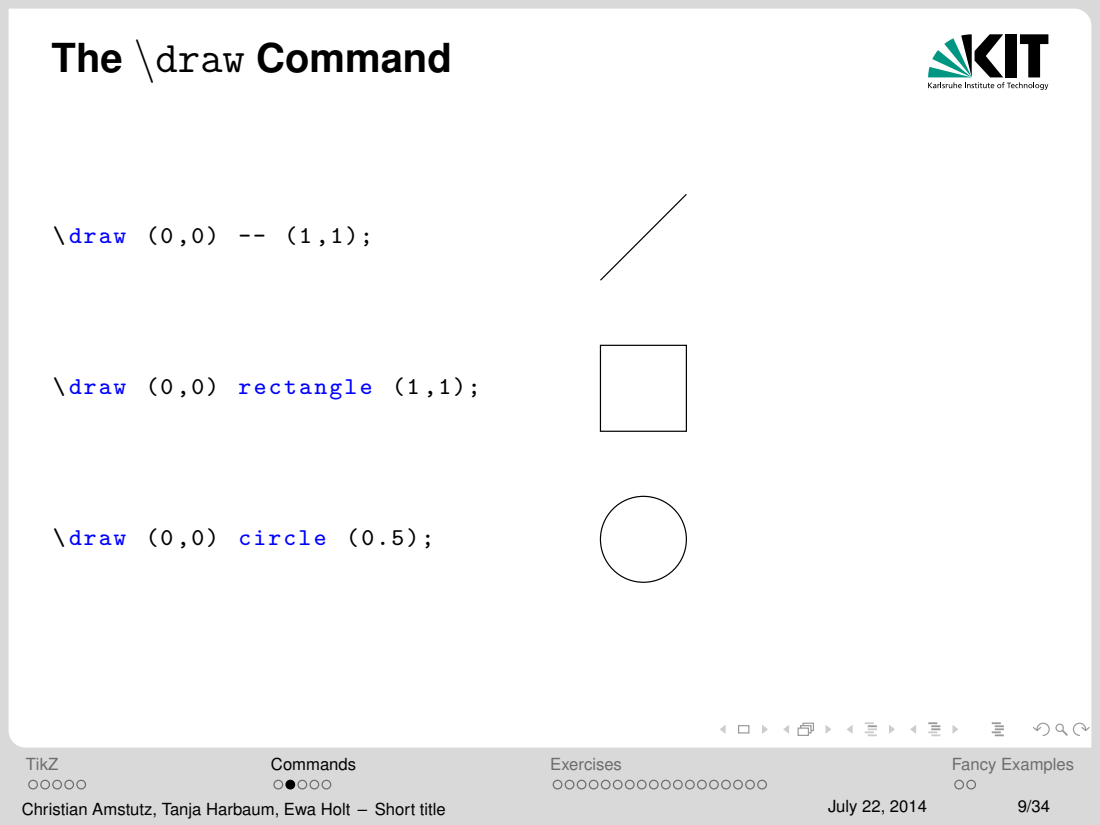
[picture p25: page 9]
\ draw (0 ,0) -- (1 ,1);; \ draw (0 ,0) rectangle (1 ,1);; \ draw (0 ,0) circle (0.5);; Christian Amstutz, Tanja Harbaum, Ewa Holt – Short title; July 22, 2014

# Coordinates

## Cartesian Coordinates (x,y)

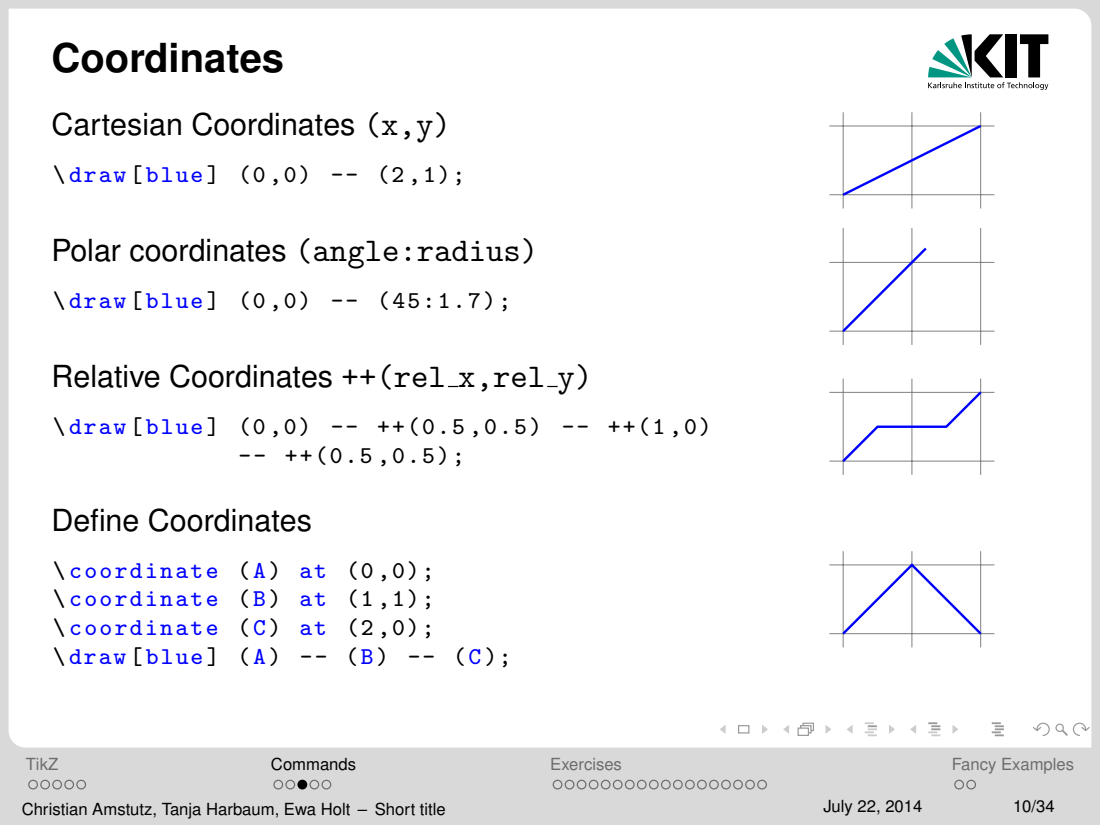
[picture p26: page 10]
\ draw [ blue ] (0 ,0) -- (2 ,1);; \ draw [ blue ] (0 ,0) -- (45:1.7);; \ draw [ blue ] (0 ,0) -- ++(0.5 ,0.5) -- ++(1 ,0) -- ++(0.5 ,0.5);; Define Coordinates; \ coordinate (A) at (0 ,0); \ coordinate (B) at (1 ,1); \ coordinate (C) at (2 ,0); \ draw [ blue ] (A) -- (B) -- (C);; Christian Amstutz, Tanja Harbaum, Ewa Holt – Short title; July 22, 2014

Polar coordinates (angle:radius)

Relative Coordinates ++(rel x,rel y)

# The \node Command

## A node is typically a rectangle or circle or another simple shape with some text on it

\ node [ rectangle , fill = green ]( rect ) { Rectangle }; | Rectangle

## Node positioning

\ node [ rectangle , fill = green ]( rect ){ Rectangle };
\ node [ circle , fill =purple , below =of rect ]( circ ){ Circle };
| Rectangle

Circle

## Connect nodes with lines

\ node [ rectangle , fill = green ]( rect ){ Rectangle };
\ node [ circle , fill =purple , below =of rect ]( circ ){ Circle }; \ draw [ - >] ( rect ) -- ( circ );

Rectangle

Circle

Christian Amstutz, Tanja Harbaum, Ewa Holt – Short title | July 22, 2014 | 11/34

# Style Definitions

## Styles are defined by [] behind a command

\ draw [red , very thick , dashed ] (0 ,0) -- (1 ,0.1);

## Styles can be named and defined locally or globally

\ tikzset {my style /. style ={ tikz options }}
\ tikzstyle {my style }=[ tikz options ] | % deprecated

## example

\ tikzset {my dot /. style ={ blue , fill =green , thick }} \ draw [my dot ] (0 ,0) circle (0.2);
\ draw [my dot ] (0.1 ,0.6) circle (0.2);
\ draw [my dot , fill = red] (0.8 ,0.2) circle (0.2);
Christian Amstutz, Tanja Harbaum, Ewa Holt – Short title | July 22, 2014 | 12/34

# Exercise 1: UML Activity Diagram

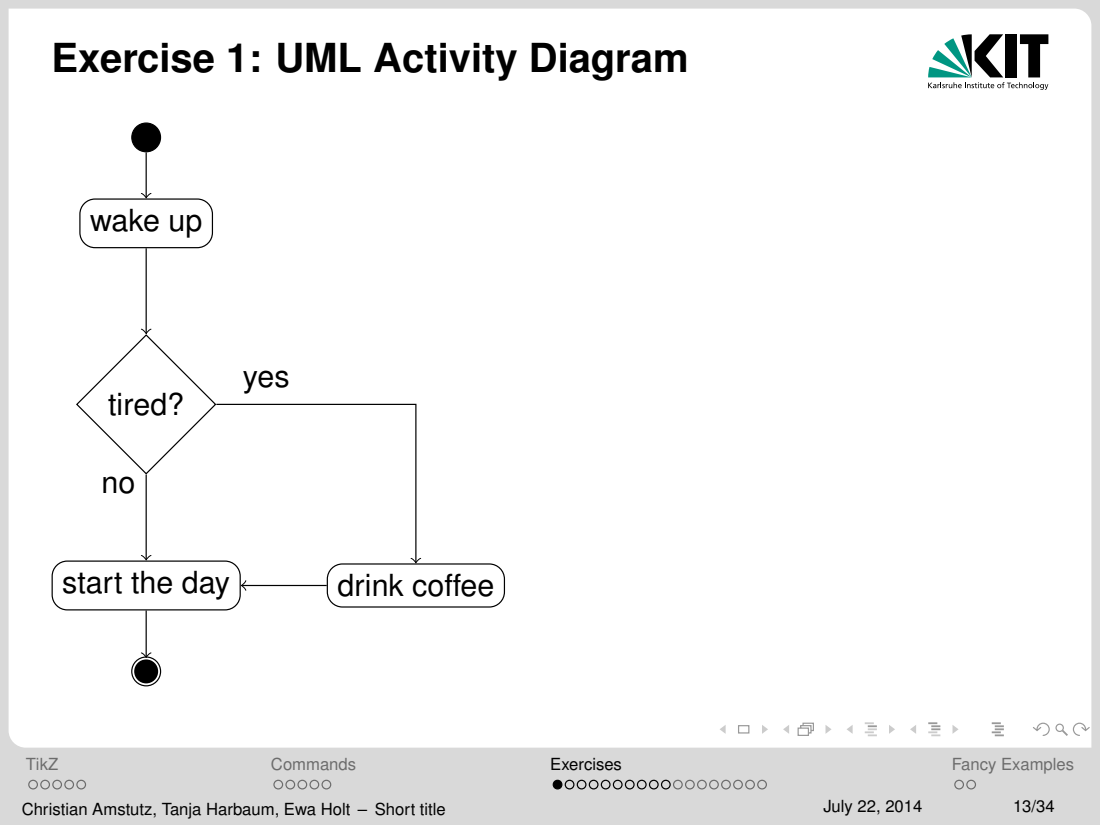
[picture p27: page 13]
wake up; tired?; start the day; drink coffee; yes; Christian Amstutz, Tanja Harbaum, Ewa Holt – Short title; July 22, 2014

# Exercise 1: UML Activity Diagram

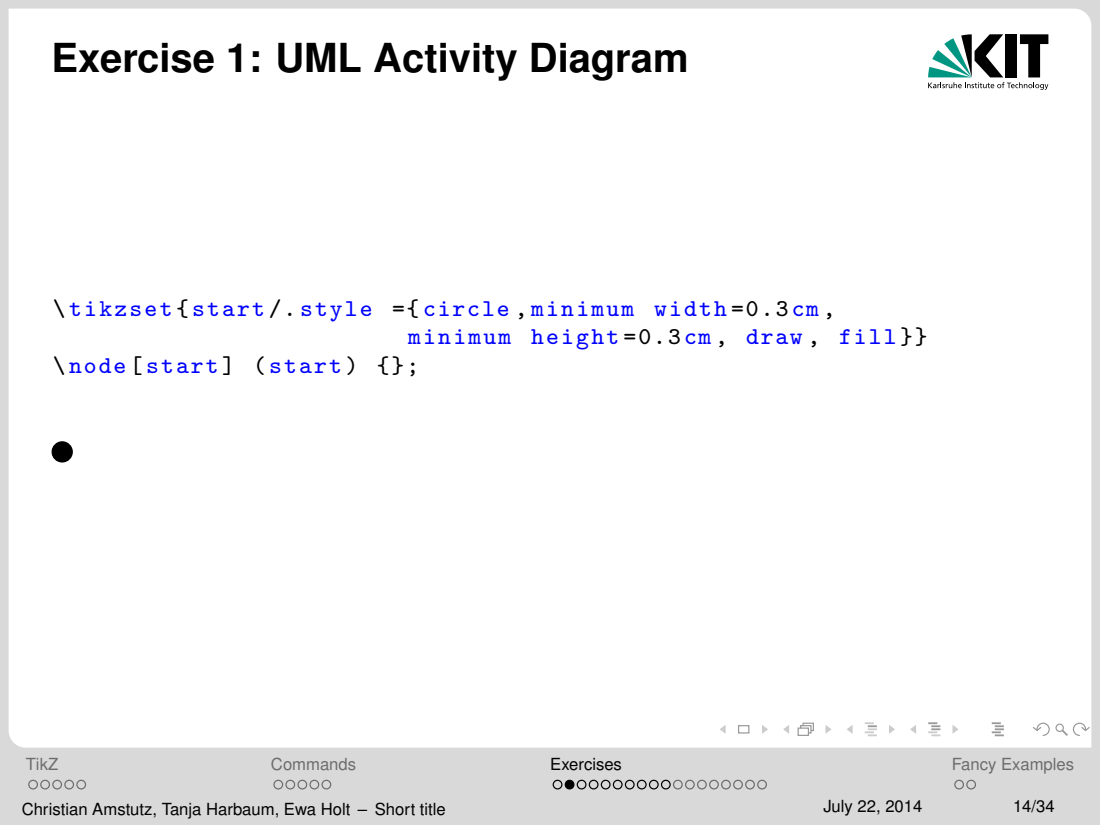
[picture p28: page 14]
Christian Amstutz, Tanja Harbaum, Ewa Holt – Short title; July 22, 2014

\ tikzset { start /. style ={ circle , minimum width =0.3 cm ,

minimum height =0.3 cm , draw , fill }}

\ node [ start ] ( start ) {};

# Exercise 1: UML Activity Diagram

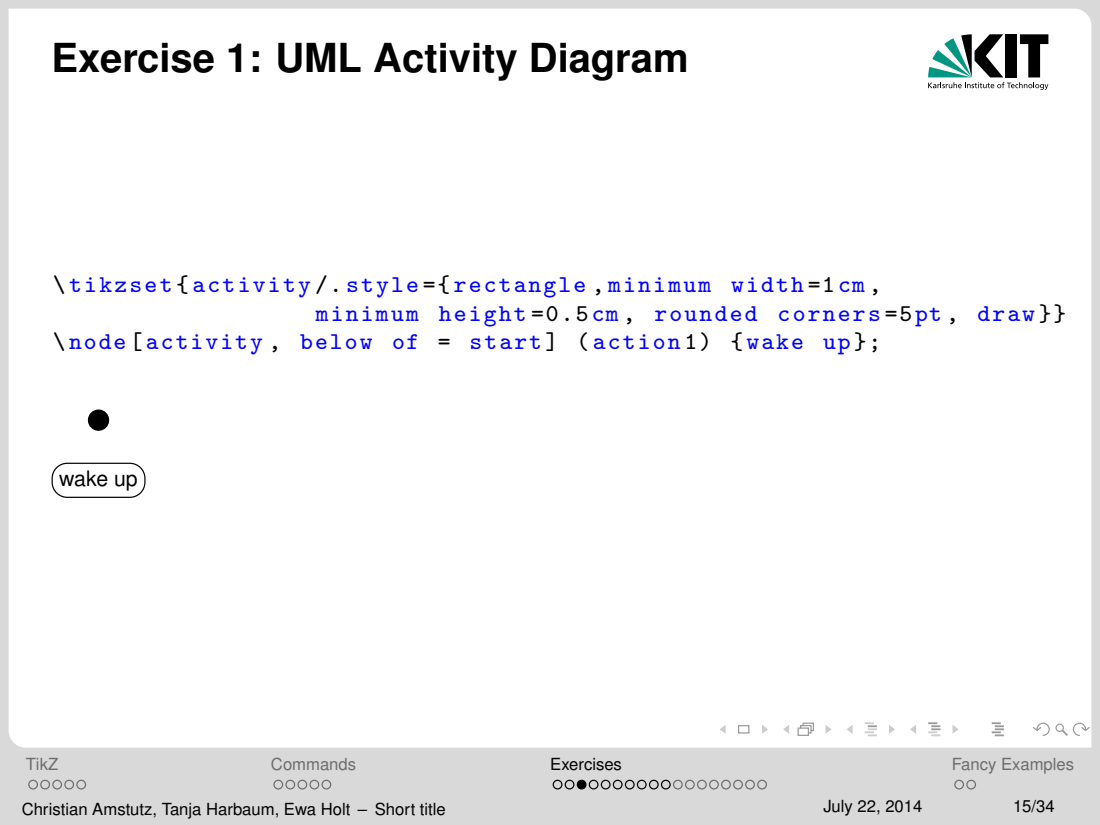
[picture p29: page 15]
wake up; Christian Amstutz, Tanja Harbaum, Ewa Holt – Short title; July 22, 2014

\ tikzset { activity /. style ={ rectangle , minimum width =1cm ,

minimum height =0.5 cm , rounded corners =5pt , draw }}

\ node [ activity , below of = start ] ( action 1) { wake up };

# Exercise 1: UML Activity Diagram

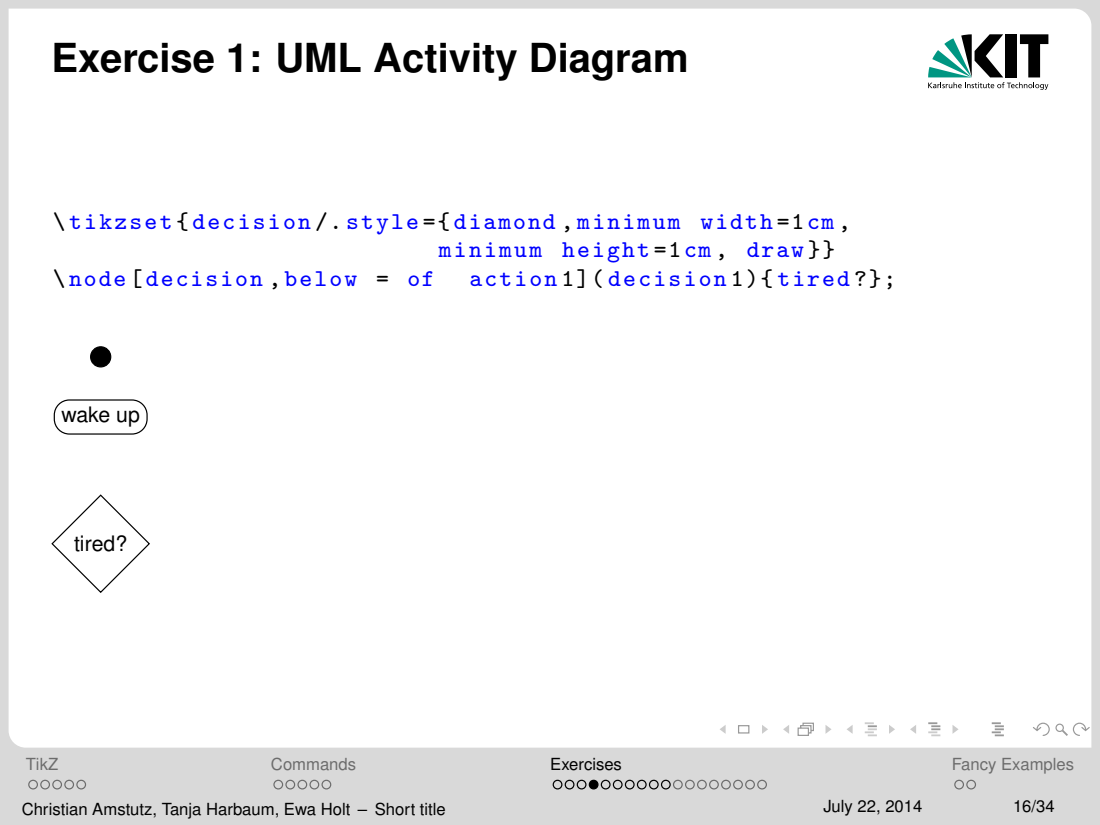
[picture p30: page 16]
\ node [ decision , below = of; action 1]( decision 1){ tired ?};; wake up; tired?; Christian Amstutz, Tanja Harbaum, Ewa Holt – Short title; July 22, 2014

\ tikzset { decision /. style ={ diamond , minimum width =1cm ,

minimum height =1cm , draw }}

# Exercise 1: UML Activity Diagram

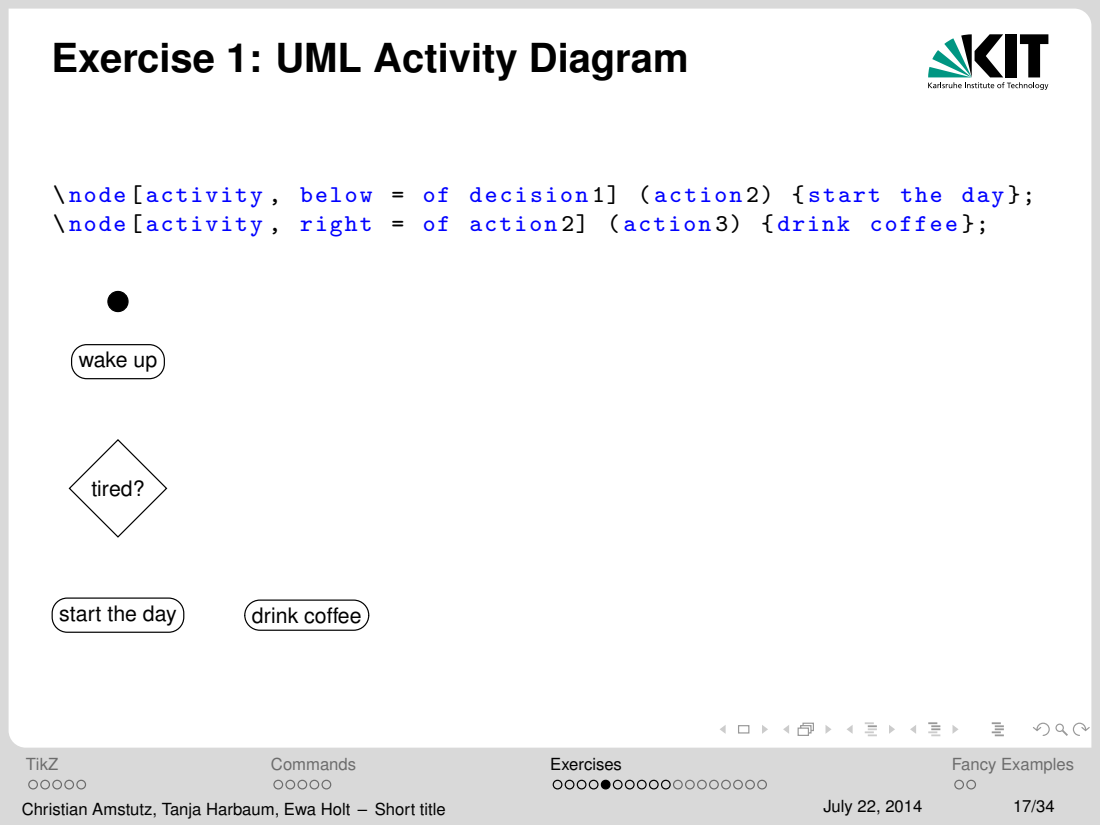
[picture p31: page 17]
wake up; tired?; start the day; drink coffee; Christian Amstutz, Tanja Harbaum, Ewa Holt – Short title; July 22, 2014

\ node [ activity , below = of decision 1] ( action 2) { start the day };
\ node [ activity , right = of action 2] ( action 3) { drink coffee };

# Exercise 1: UML Activity Diagram

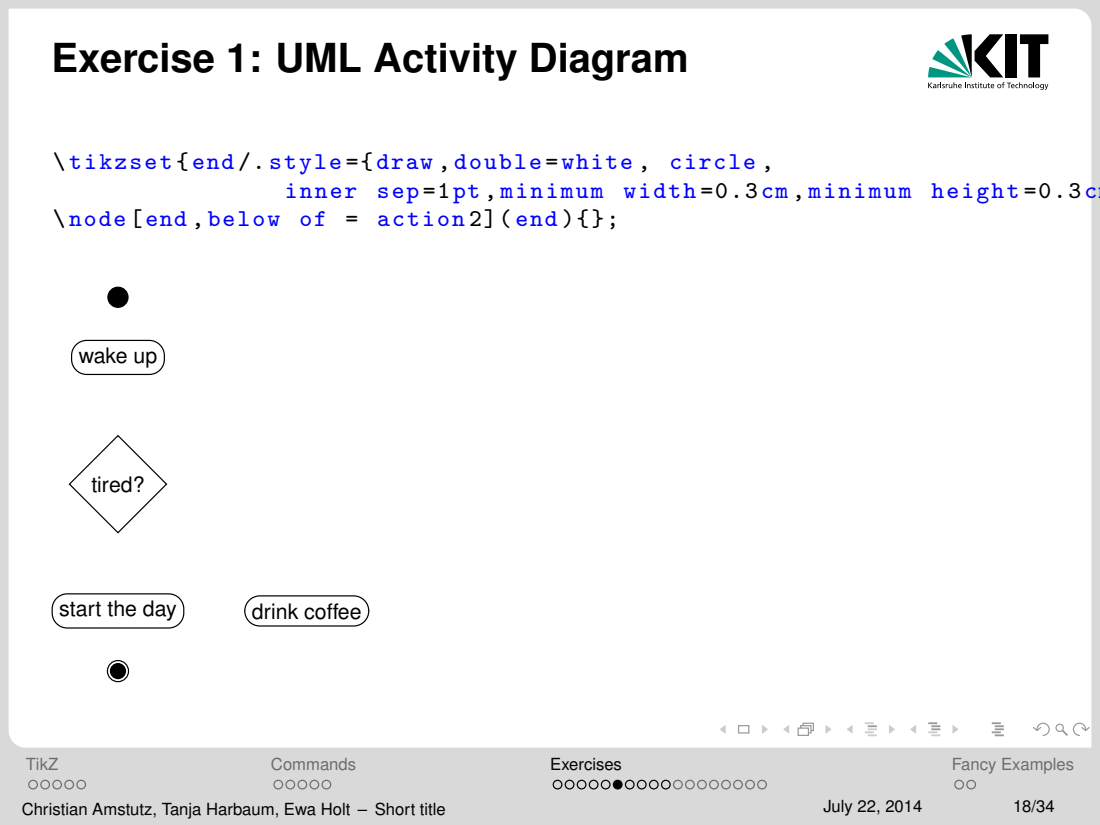
[picture p32: page 18]
wake up; tired?; start the day; drink coffee; Christian Amstutz, Tanja Harbaum, Ewa Holt – Short title; July 22, 2014

\ tikzset { end /. style ={ draw , double =white , circle ,

inner sep =1pt , minimum width =0.3 cm , minimum height =0.3 cm , fill }}

\ node [end , below of = action 2]( end ){};

# Exercise 1: UML Activity Diagram

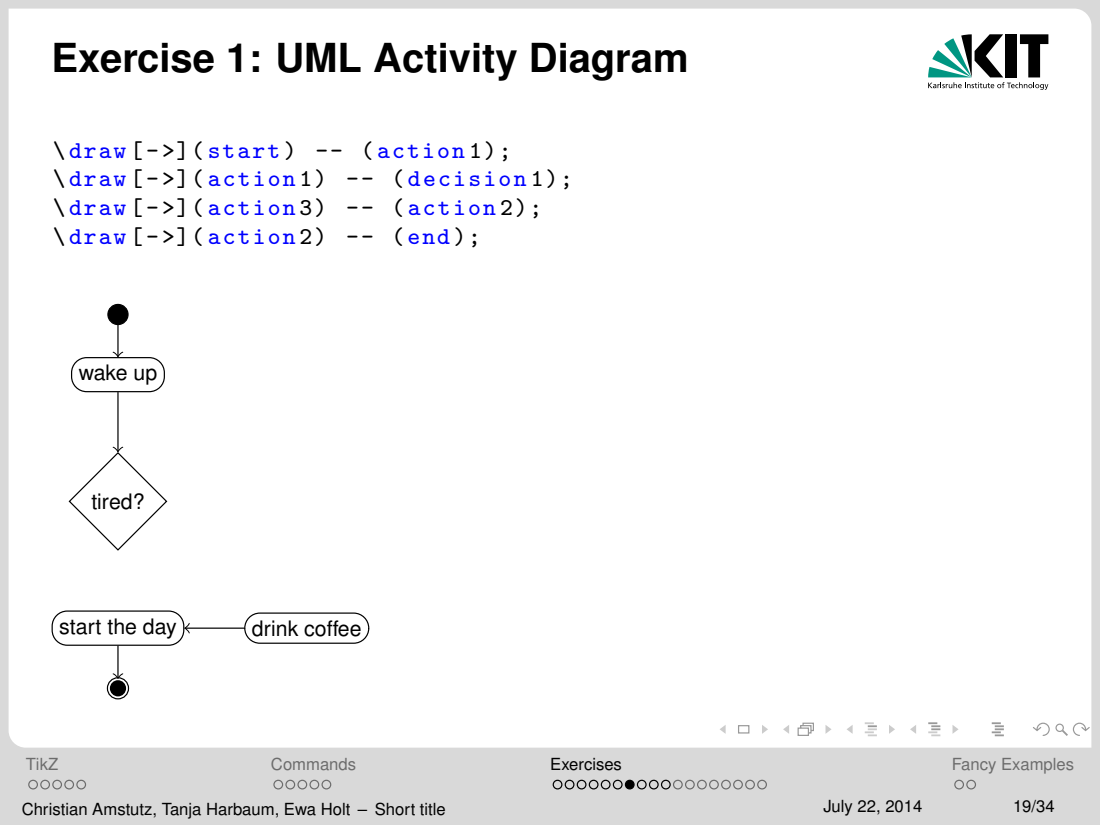
[picture p33: page 19]
wake up; tired?; start the day; drink coffee; Christian Amstutz, Tanja Harbaum, Ewa Holt – Short title; July 22, 2014

\ draw [ - >]( start ) -- ( action 1);
\ draw [ - >]( action 1) -- ( decision 1);
\ draw [ - >]( action 3) -- ( action 2);
\ draw [ - >]( action 2) -- ( end );

# Exercise 1: UML Activity Diagram

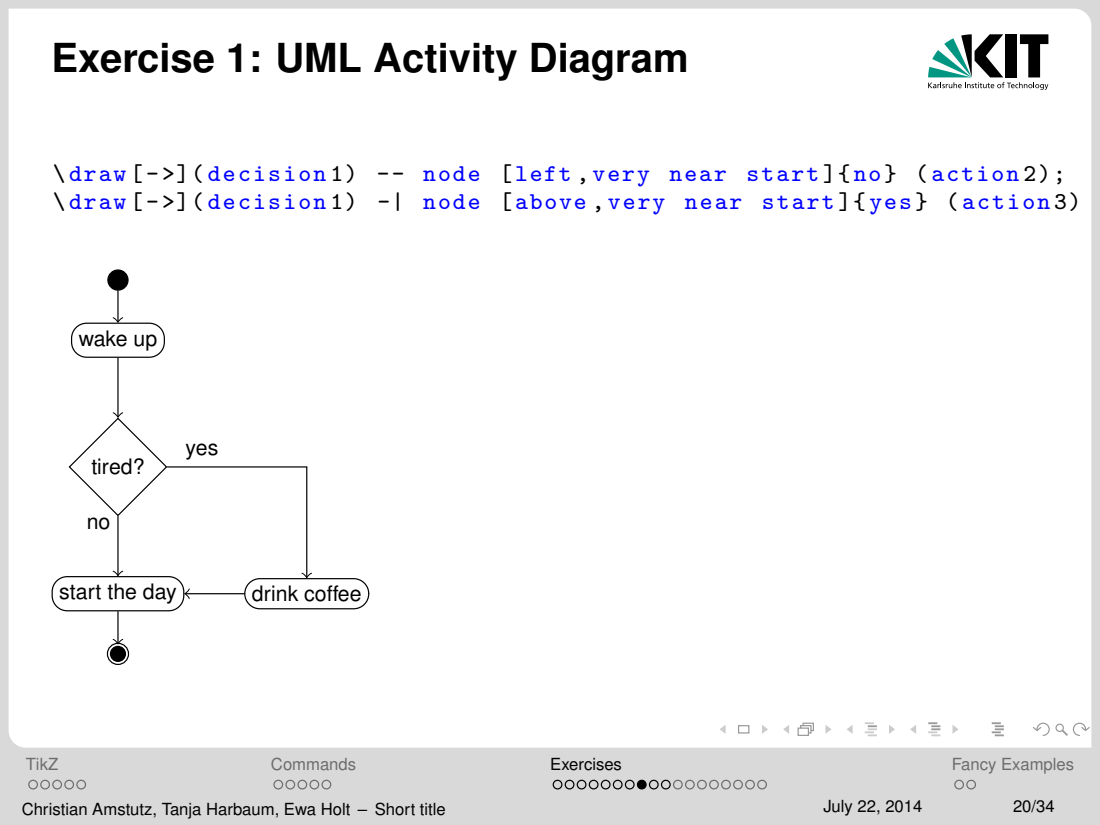
[picture p34: page 20]
wake up; tired?; start the day; drink coffee; yes; Christian Amstutz, Tanja Harbaum, Ewa Holt – Short title; July 22, 2014

\ draw [ - >]( decision 1) -- node [left , very near start ]{ no} ( action 2);
\ draw [ - >]( decision 1) -| node [above , very near start ]{ yes } ( action 3) ;

# Exercise 1: UML Activity Diagram -Solution I

%\ u s e t i k z l i b r a r y { shapes }
\ begin { tikzpicture }

\ tikzset { activity /. style ={ rectangle , minimum width =1cm , minimum height =0.5 cm , rounded corners =5pt , draw }}
\ tikzset { decision /. style ={ diamond , minimum width =1cm , minimum height =1cm , draw }}
\ tikzset { end /. style ={ draw , double =white , circle , inner sep =1pt , minimum width =0.3 cm , minimum height =0.3 cm , fill }} \ tikzset { start /. style ={ circle , minimum width =0.3 cm , minimum height =0.3 cm , draw , fill }}

\ node [ start ] ( start ) {};
\ node [ activity , below of = start ] ( action 1) { wake up };
\ node [ decision , below = of | action 1]( decision 1){ tired ?};
\ node [ activity , below = of | decision 1] ( action 2) { start the day };
\ node [ activity , right = of action 2] ( action 3) { drink coffee };
\ node [end , below of = action 2]( end ){};
Christian Amstutz, Tanja Harbaum, Ewa Holt – Short title | July 22, 2014 | 21/34

# Exercise 1: UML Activity Diagram -Solution II

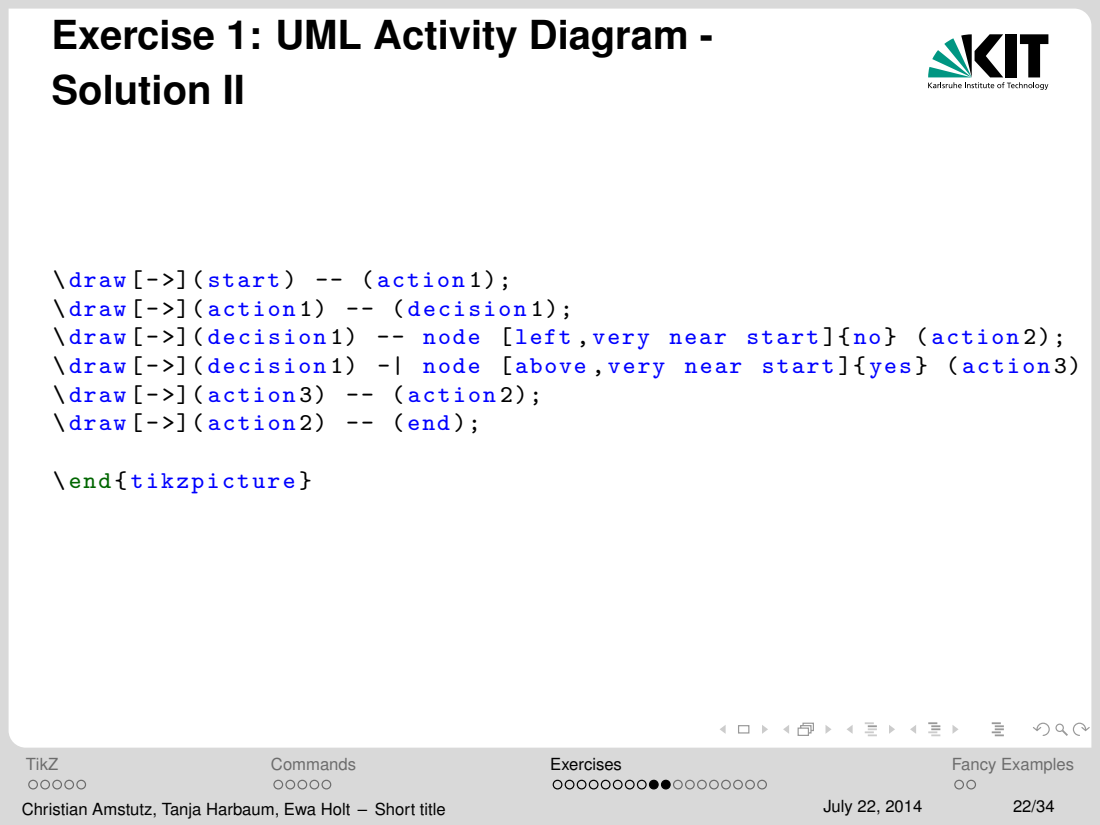
[picture p35: page 22]
\ end { tikzpicture }; Christian Amstutz, Tanja Harbaum, Ewa Holt – Short title; July 22, 2014

\ draw [ - >]( start ) -- ( action 1);
\ draw [ - >]( action 1) -- ( decision 1);
\ draw [ - >]( decision 1) -- node [left , very near start ]{ no} ( action 2);
\ draw [ - >]( decision 1) -| node [above , very near start ]{ yes } ( action 3) ;
\ draw [ - >]( action 3) -- ( action 2);
\ draw [ - >]( action 2) -- ( end );

# Exercise 2: p-p collision

p

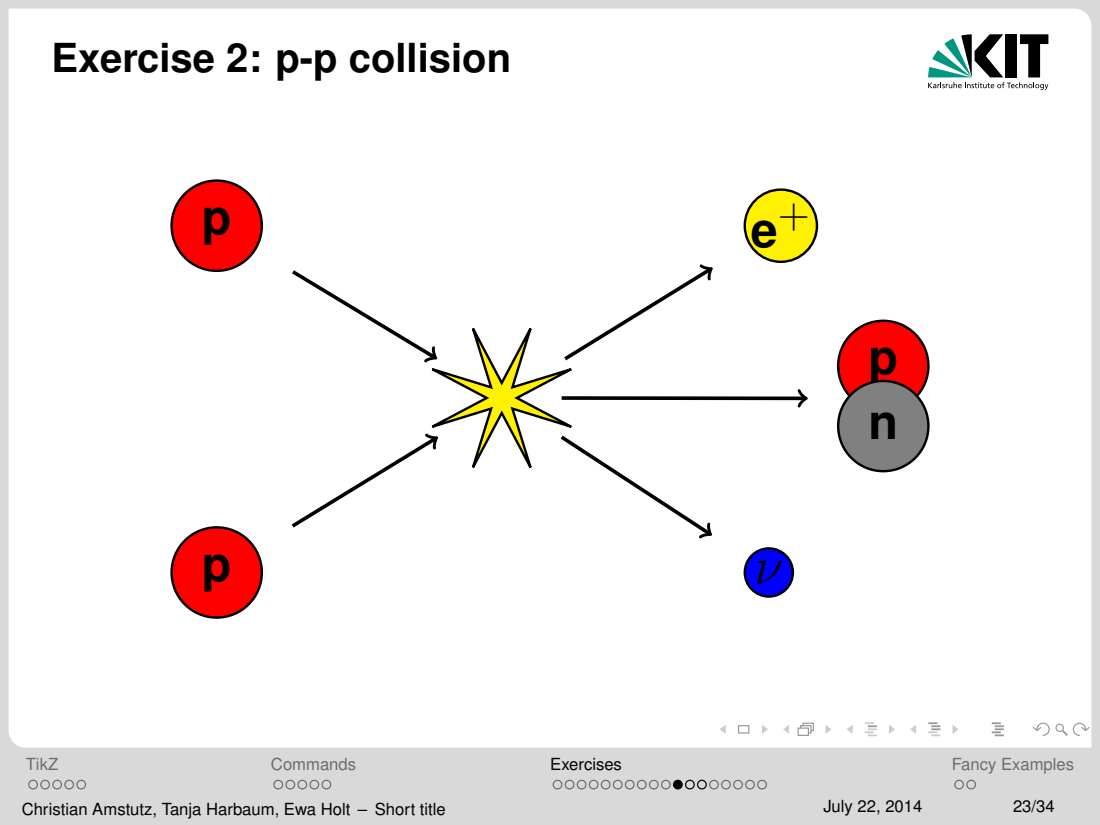
[picture p36: page 23]
Christian Amstutz, Tanja Harbaum, Ewa Holt – Short title; July 22, 2014

# Exercise 2: p-p collision - Solution I

\ begin { tikzpicture }[ scale =0.7 , transform shape ]
\ tikzset { proton /. style ={ circle , black , thick , fill =red , minimum width =1.5 cm , minimum height =1.5 cm , draw }} \ tikzset { neutron /. style ={ circle , black , thick , fill =gray , minimum width =1.5 cm , minimum height =1.5 cm , draw }} \ tikzset { collision /. style ={ star , star points =8 ,
star point ratio =0.2 , black , thick , fill = yellow , minimum width =0.5 cm , minimum height =0.5 cm , draw }} \ tikzset { neutrino /. style ={ circle , black , thick , fill =blue , minimum width =0.8 cm , minimum height =0.8 cm , draw }} \ tikzset { positron /. style ={ circle , black , thick , fill = yellow , minimum width =1.2 cm , minimum height =1.2 cm , draw }} \ tikzset { myarrow /. style ={ - > , shorten >=0.5cm , shorten <=0.5cm , very thick }}

\ node [ proton ] ( proton 1) {};
\ node [ font =\ Huge ] {\ textbf {p }};
\ node [ proton , below = 5cm] ( proton 2) {};
\ node [ font =\ Huge ] at ( proton 2) {\ textbf {p }};
\ node [ collision , | below right = 2.125 cm and 4cm of proton 1]
Christian Amstutz, Tanja Harbaum, Ewa Holt – Short title | July 22, 2014 | 24/34

# Exercise 2: p-p collision - Solution II

( collision ) {};
\ node [ positron , right = 8cm of proton 1] ( positron ) {}; \ node [ font =\ Huge ] at ( positron ) {\ textbf {e $^+$}};
\ node [ neutrino , right = 8cm of proton 2] ( neutrino ) {}; \ node [ font =\ Huge ] at ( neutrino ) {\ textbf {$\ nu $}};
\ node [ proton , below right = 1.25 cm and 10 cm of proton 1] ( proton 3) {};
\ node [ font =\ Huge ] at ( proton 3) {\ textbf {p }};
\ node [ neutron , below of = proton 3] ( neutron ) {};
\ node [ font =\ Huge ] at ( neutron ) {\ textbf {n}};

\ draw [ myarrow ] ( proton 1) -- ( collision );
\ draw [ myarrow ] ( proton 2) -- ( collision );
\ draw [ myarrow ] ( collision ) -- ( positron );
\ draw [ myarrow ] ( collision ) -- ( neutrino );
\ draw [ myarrow ] ( collision ) -- ( proton 3. south west ); \ end { tikzpicture }
Christian Amstutz, Tanja Harbaum, Ewa Holt – Short title | July 22, 2014 | 25/34

# Plotting Data

f(x)

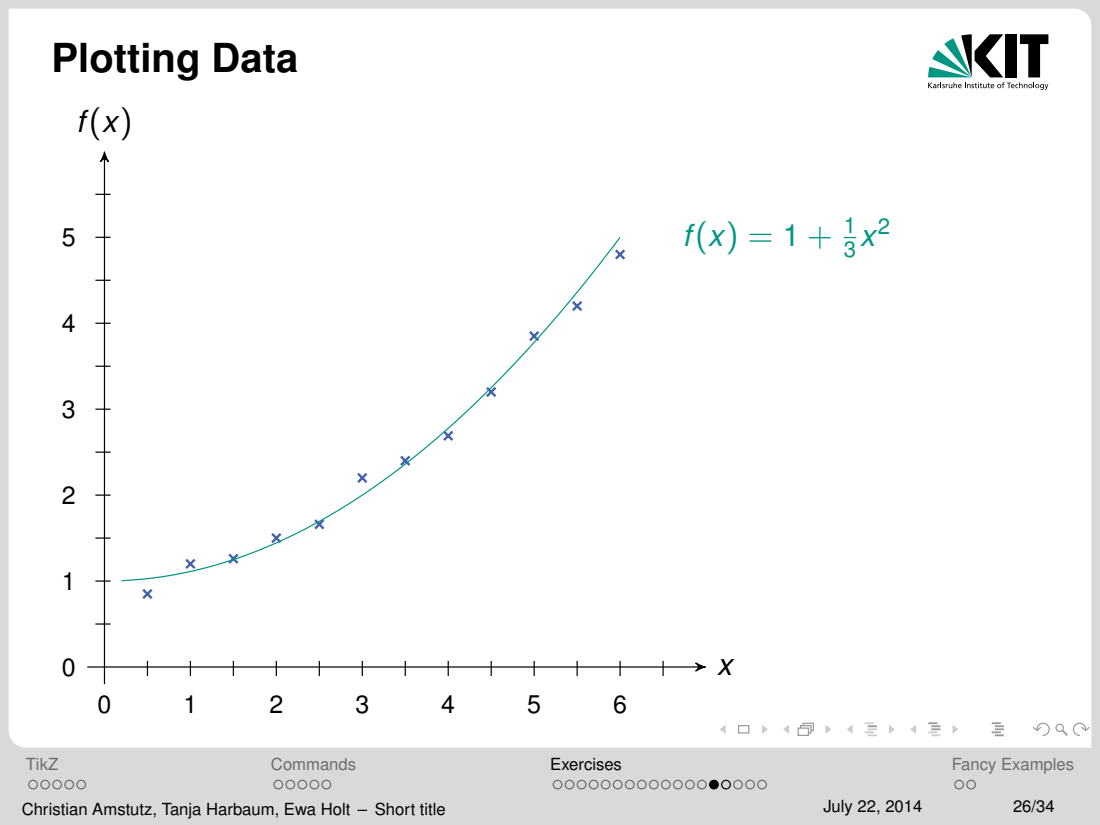
[picture p37: page 26]
Christian Amstutz, Tanja Harbaum, Ewa Holt – Short title; July 22, 2014

# Plotting data - Code

\ begin { tikzpicture }[ domain =0.2:6]

\ draw [- >, >= stealth ’] ( -0.2 ,0) -- (7 ,0) node [ right ] {$x $};
\ draw [- >, >= stealth ’] (0 , -0.2) -- (0 ,6) node [ above ] {$f(x )$};

\ foreach \x in {0.5 ,1 ,1.5 ,2 ,2.5 ,3 ,3.5 ,4 ,4.5 ,5 ,5.5 ,6 ,6.5}
\ draw (\x ,2 pt) -- (\x , -3 pt );
\ foreach \x in {0 ,1 ,2 ,3 ,4 ,5 ,6}
\ node at (\x , -6 pt) [ anchor = north ] {\ footnotesize $\x $}; \ foreach \y/\ ytext in {0.5 ,1 ,1.5 ,2 ,2.5 ,3 ,3.5 ,4 ,4.5 ,5 ,5.5}
\ draw (2pt ,\y) -- ( -3pt ,\y cm );
\ foreach \y/\ ytext in {0 ,1 ,2 ,3 ,4 ,5}
\ node at ( -6pt ,\y) [ anchor = east ] {\ footnotesize $\ ytext $};

\ draw plot [ only marks , mark =x, mark options ={ kit - blue 100 , thick }] file { working _ material / measurement .dat };
\ draw [ color =kit - green 100] plot [ smooth ] (\x, {1+ pow ((1/3)*\x, 2)}) node [right , xshift =6 mm] {$f(x) = 1+\ frac {1}{3} x ^{2}$};
Christian Amstutz, Tanja Harbaum, Ewa Holt – Short title | July 22, 2014 | 27/34

# Mind Map

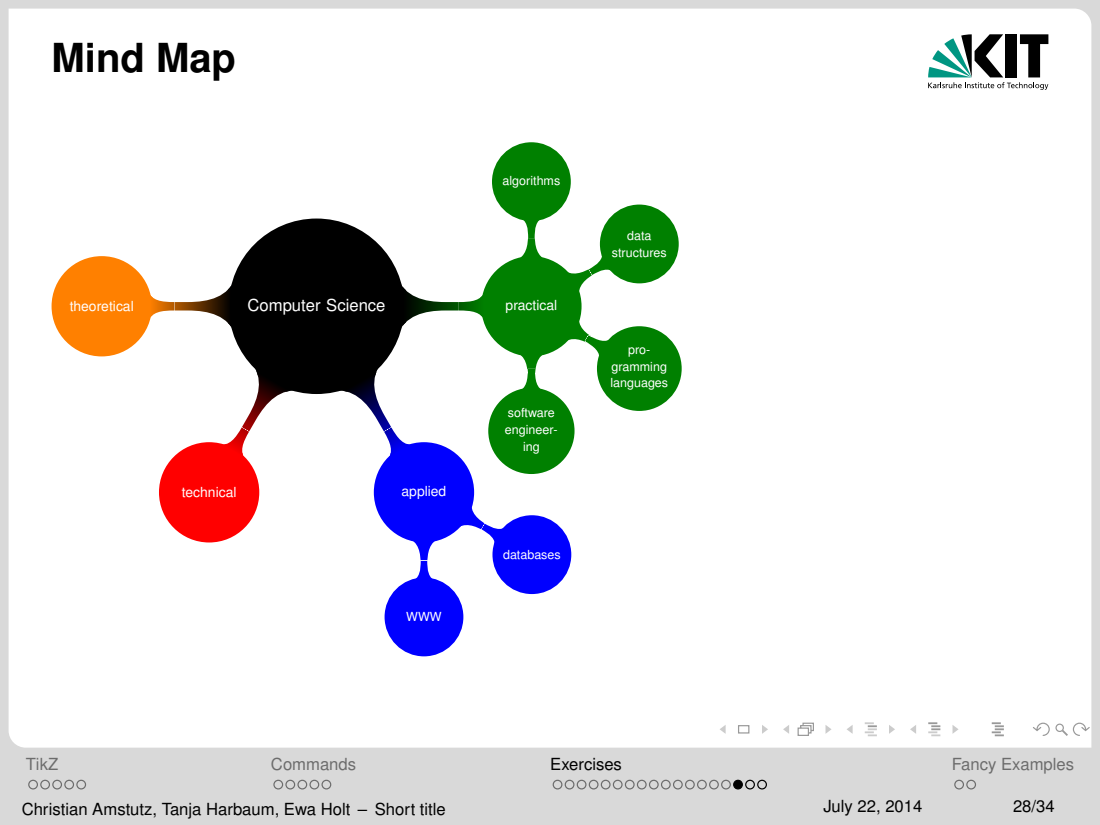
[picture p38: page 28]
Computer Science; practical; algorithms; data structures; pro- gramming languages; software engineer- ing; applied; databases; WWW; technical; theoretical; Christian Amstutz, Tanja Harbaum, Ewa Holt – Short title; July 22, 2014

# Mind Map - Code I

\ usetikzlibrary { mindmap , trees }

\ begin { tikzpicture }[ scale =0.5 , transform shape ] \ path [ mindmap , concept color =black , text = white ] node [ concept ] { Computer Science }
[ clockwise from =0]
child [ concept color = green !50! black ] {
node [ concept ] { practical }
[ clockwise from =90]
child { node [ concept ] { algorithms } }
child { node [ concept ] { data structures } }
child { node [ concept ] { pro \- gramming languages } } child { node [ concept ] { software engineer \ -ing} } }
child [ concept color = blue ] {
node [ concept ] { applied }
[ clockwise from = -30]
child { node [ concept ] { databases } } child { node [ concept ] { WWW } }
Christian Amstutz, Tanja Harbaum, Ewa Holt – Short title | July 22, 2014 | 29/34

# Mind Map - Code II

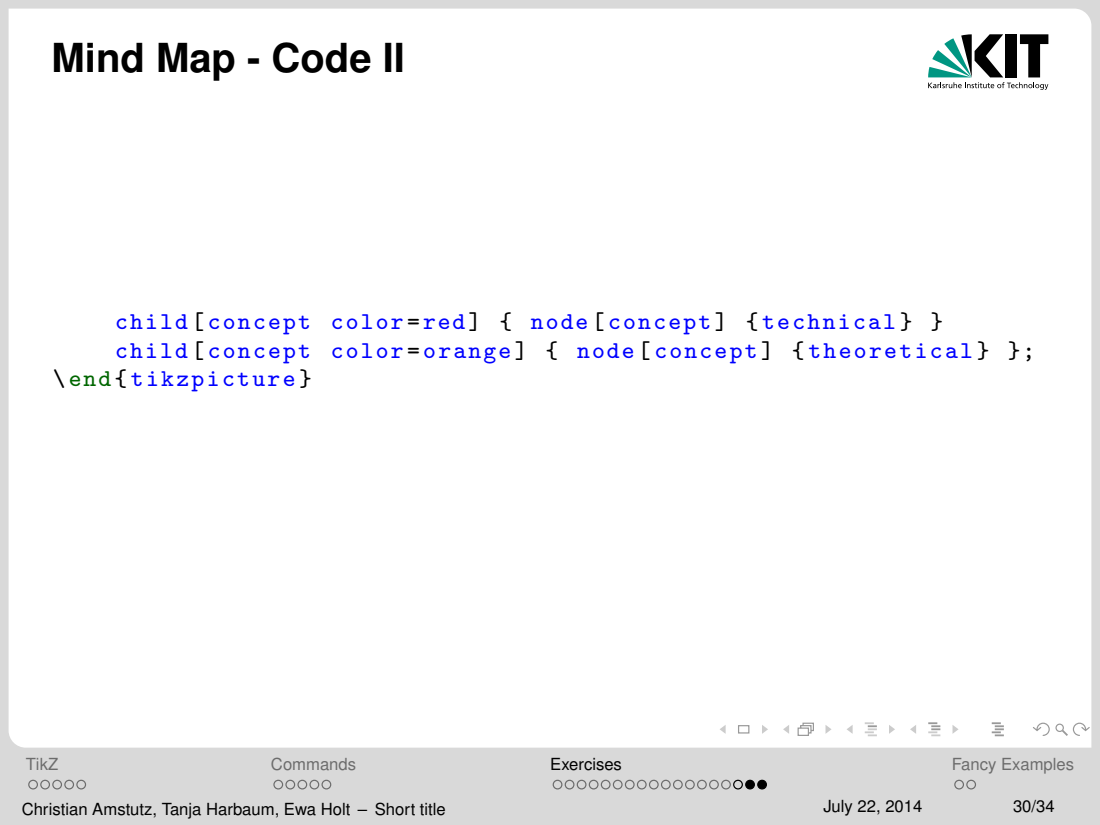
[picture p39: page 30]
\ end { tikzpicture }; Christian Amstutz, Tanja Harbaum, Ewa Holt – Short title; July 22, 2014

child [ concept color = red ] { node [ concept ] { technical } }
child [ concept color = orange ] { node [ concept ] { theoretical } };

# Fancy Examples - Polarizing Microscope

y

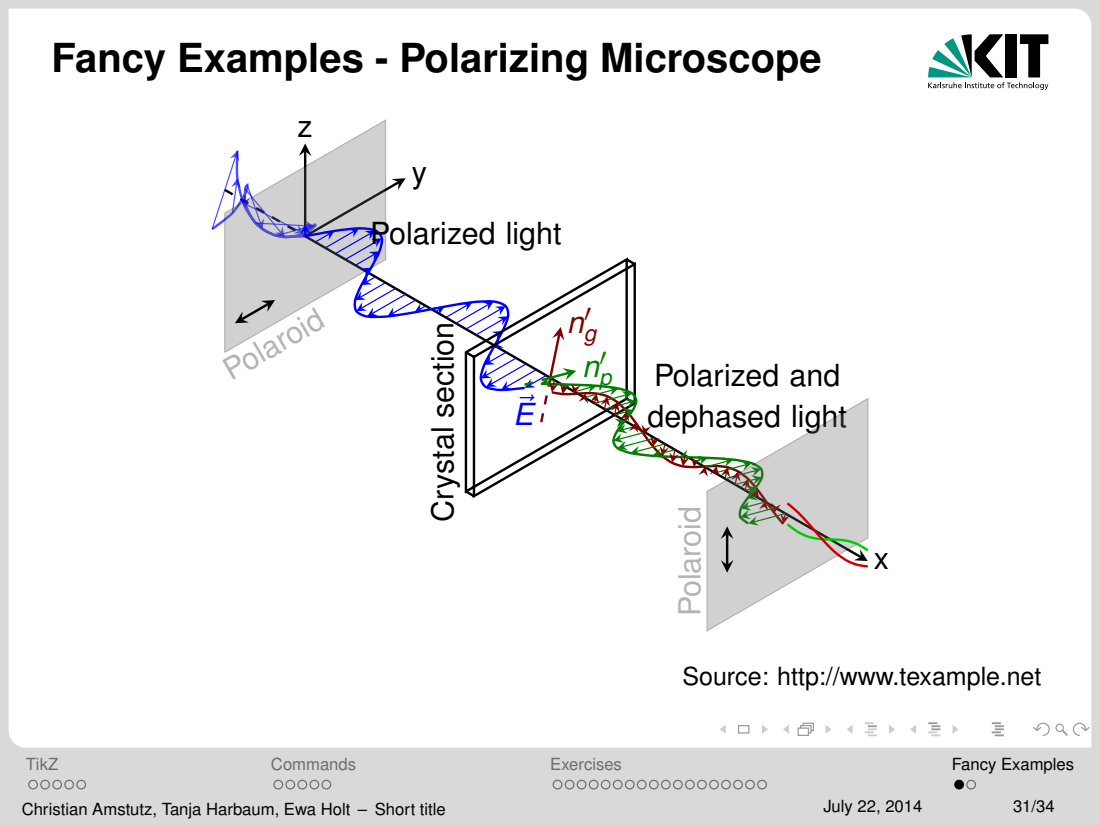
[picture p40: page 31]
Polaroid; Polarized and; Christian Amstutz, Tanja Harbaum, Ewa Holt – Short title; July 22, 2014

Polarized light Crystal section

dephased light Polaroid

Source: http://www.texample.net

# Fancy Examples - Dipolar magnetic field

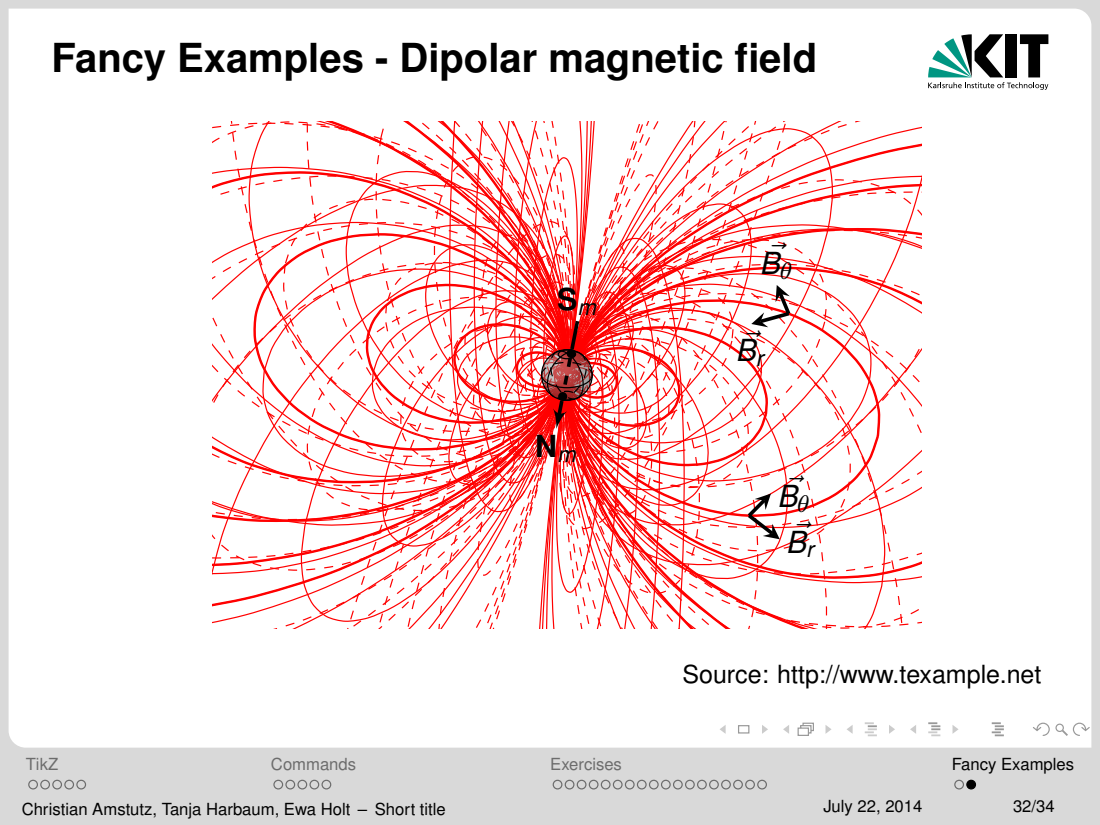
[picture p41: page 32]
Christian Amstutz, Tanja Harbaum, Ewa Holt – Short title; July 22, 2014

Source: http://www.texample.net

# More information

## Website with nice TikZ examples:

## http://www.texample.net/tikz/examples

## A very minimal introduction to TikZ - A short and good introduction:

## http://cremeronline.com/LaTeX/minimaltikz.pdf

TikZ PGF Manual (Version 3.0) - great resource written in clear,

## comprehensible language:

## http://mirrors.ctan.org/graphics/pgf/base/doc/pgfmanual.pdf

## TikZ Cheat Sheet - Short cheatsheet far from being complete:

## http://home.snc.edu/andershendrickson/tex/TikZcheatsheet.pdf

## This tutorial with all the sources:

## https://github.com/camstutz/tikz tutorial (https://github.com/camstutz/tikz_tutorial)

Christian Amstutz, Tanja Harbaum, Ewa Holt – Short title | July 22, 2014 | 33/34

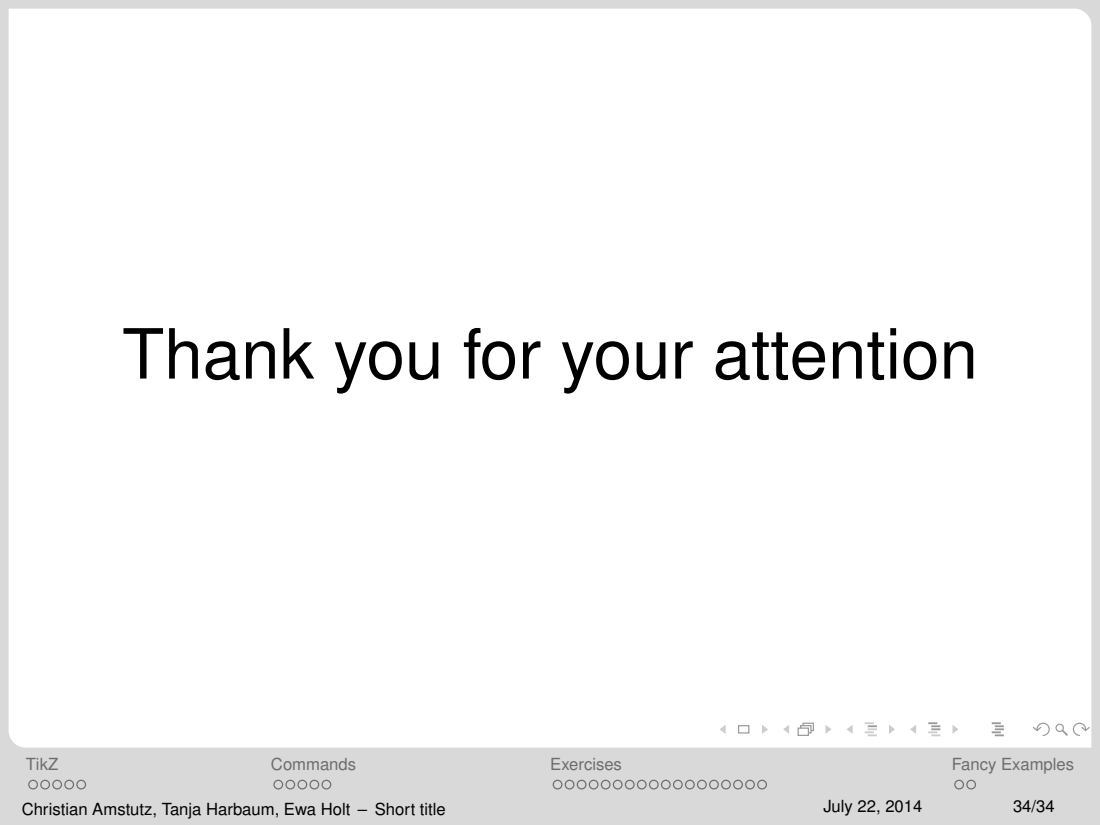
[picture p42: page 34]
Christian Amstutz, Tanja Harbaum, Ewa Holt – Short title; July 22, 2014

Thank you for your attention
