asiggel/rwu-rv64iV2.0/RWU_RV/RV_NoPipeline/spec/01_docover_history_tab01.tex

\begin{table}[H]
%\begin{table}[ht]
\caption{Spec Changes as compared to the previous \aschip \; Spec Revision}
\label{tab:docover_history01}
\centering
\begin{tabularx}{\textwidth}{|X |X |X |}
  \hline
  \multicolumn{3}{|l|}{History} \\
  \hline
  \multicolumn{1}{|l}{Target Spec.} & \multicolumn{1}{l}{Current version : 1.1, 2026-06-05} & \multicolumn{1}{l|}{Author: A. Siggelkow}\\
  \multicolumn{1}{|l}{ } & \multicolumn{1}{l}{Previous version : 1.0, 2022-11-22} & \multicolumn{1}{l|}{ }\\
  \hline
  \hline
  Paragraph (in previous version) & Paragraph (in current version) / date & Subjects (major changes since last revision) \\
  \hline
  \hline
  \multicolumn{3}{|l|}{Current Chapter Version: C0.1; Date: 2022-11-22} \\
  \hline
  & 2022-11-22 & First draft (AS) \\
  \hline
  \multicolumn{3}{|l|}{Current Chapter Version: C0.2; Date: 2026-06-05} \\
  \hline
  & 2026-06-05 & UART0 integration: \texttt{ip\_uart\_v2} IP, UART TX/RX simulation testbenches, RX FIFO pop bug fix in \texttt{as\_uart\_top.sv} (AS, Claude) \\
  \hline
\end{tabularx}
\end{table}
