asiggel/rwu-rv64iV2.0/RWU_RV/RV_NoPipeline/spec/01_docover_history_tab02.tex

\begin{table}[H]
%\begin{table}[ht]
\caption{History}
\label{tab:docover_history02}
\centering
\begin{tabularx}{\textwidth}{|X |X |X |}
  \hline
  \multicolumn{3}{|l|}{History} \\
  \hline
  \multicolumn{1}{|l}{Target Spec.} & \multicolumn{1}{l}{Current version : 1.0, 2022-11-22} & \multicolumn{1}{l|}{Author: A. Siggelkow}\\
  \multicolumn{1}{|l}{ } & \multicolumn{1}{l}{Previous version : 0.0, 2020-10-12} & \multicolumn{1}{l|}{ }\\
  \hline
  \hline
  Paragraph (in previous version) & Paragraph (in current version) / date & Subjects (major changes since last revision) \\
  \hline
  \hline
  \multicolumn{3}{|l|}{Current Chapter Version: C0.1; Date: 2022-11-22} \\
  \hline
  & 2022-11-22 & First draft (AS) \\
  \hline
\end{tabularx}
\end{table}
