asiggel/rwu-rv64iV2.0/RWU_RV/RV_NoPipeline/spec/02_prod/02_product_history_tab03.tex

\begin{table}[H]
%\begin{table}[ht]
\caption{History}
\label{tab:product_history03}
\centering
\begin{tabularx}{\textwidth}{|X |X |X |}
  \hline
  \multicolumn{3}{|l|}{History} \\
  \hline
  \multicolumn{1}{|l}{Target Spec.} & \multicolumn{1}{l}{Current version : 1.0, 2025-02-22} & \multicolumn{1}{l|}{Author: A. Siggelkow}\\
  \multicolumn{1}{|l}{ } & \multicolumn{1}{l}{Previous version : 0.0, 2020-10-12} & \multicolumn{1}{l|}{ }\\
  \hline
  \hline
  Paragraph (in previous version) & Paragraph (in current version) / date & Subjects (major changes since last revision) \\
  \hline
  \hline
  \multicolumn{3}{|l|}{Current Chapter Version: C0.1; Date: 2025-02-22} \\
  \hline
  & 2025-02-22 & First draft (AS) \\
  \hline
  & 2026-07-12 & First draft (AS) \\
  \hline
  & 2026-07-14 & Documented \texttt{ecall}/\texttt{ebreak} exceptions (mcause 11/3), both variants (AS) \\
  \hline
  Interrupt Concept & 2026-11-06 & Rewritten for the shared trap/CSR unit \texttt{cc\_trap\_csr}:
    precise traps, MSI/MTI inputs for a CLINT, vectored \texttt{mtvec}, WARL CSRs,
    \texttt{mscratch}/\texttt{mhartid}/\texttt{misa}/counters, \texttt{wfi},
    \texttt{mstatus.MIE}\,=\,0 after reset (CC) \\
  \hline
\end{tabularx}
\end{table}
