asiggel/rwu-rv64iV2.0/RWU_RV/RV_NoPipeline/spec/05_gpio/05_gpio_history_tab02.tex

\begin{table}[H]
\caption{History}
\label{tab:gpiohistory02}
%\begin{table}[ht]
\centering
\begin{tabularx}{\textwidth}{|X |X |X |}
  \hline
  \multicolumn{3}{|l|}{History} \\
  \hline
  \multicolumn{1}{|l}{Target Spec.} & \multicolumn{1}{l}{Current version : 1.0, 2025-02-13} & \multicolumn{1}{l|}{Author: A. Siggelkow}\\
  \multicolumn{1}{|l}{ } & \multicolumn{1}{l}{Previous version : 0.0, 2020-10-12} & \multicolumn{1}{l|}{ }\\
  \hline
  \hline
  Paragraph (in previous version) & Paragraph (in current version) / date & Subjects (major changes since last revision) \\
  \hline
  \hline
  \multicolumn{3}{|l|}{Current Chapter Version: C0.1; Date: 2025-02-13} \\
  \hline
  \ref{sec:gpiofunc01} & \ref{sec:gpiofunc01} / 2025-02-13 & First draft (AS) \\
  \hline
  \ref{sec:gpiofunc01} & \ref{sec:gpiofunc01} / 2025-11-19 & Changed the BPI; removed the registers from the kernel and added them to GPIOTop. Added an interrupt. Removed the address output. changed the GPIO output to inout. (AS) \\
  \hline
  \multicolumn{3}{|l|}{Current Chapter Version: C0.2; Date: 2026-11-06} \\
  \hline
  \ref{sec:gpiofunc01} & \ref{subsec:gpioirqregs} / 2026-11-06 & Interrupt registers implemented by shared block as\_irq\_peripheral; IRQSC/ISR write strobes; per-bit IRQSS clear; new ICR register (0x50); RIS[0] as level. (AS, Claude) \\
  \hline
\end{tabularx}
\end{table}
