asiggel/rwu-rv64iV2.0/RWU_RV/RV_NoPipeline/spec/05_imem/05_imem_history_tab02.tex

\begin{table}[H]
\caption{History}
\label{tab:imemhistory02}
%\begin{table}[ht]
\centering
\begin{tabularx}{\textwidth}{|X |X |X |}
  \hline
  \multicolumn{3}{|l|}{History} \\
  \hline
  \multicolumn{1}{|l}{Target Spec.} & \multicolumn{1}{l}{Current version : 1.0, 2025-11-27} & \multicolumn{1}{l|}{Author: A. Siggelkow}\\
  \multicolumn{1}{|l}{ } & \multicolumn{1}{l}{Previous version : 0.0, 2020-10-12} & \multicolumn{1}{l|}{ }\\
  \hline
  \hline
  Paragraph (in previous version) & Paragraph (in current version) / date & Subjects (major changes since last revision) \\
  \hline
  \hline
  \multicolumn{3}{|l|}{Current Chapter Version: C0.1; Date: 2025-11-27} \\
  \hline
  \ref{sec:imemfunc01} & \ref{sec:imemfunc01} / 2025-11-27 & First draft (AS) \\
  \hline
\end{tabularx}
\end{table}
