asiggel/rwu-rv64iV2.0/RWU_RV/RV_NoPipeline/spec/05_gpio/05_gpio_history_tab01.tex

Regulations for history table:
\begin{itemize}
  \item Last version on top.
  \item Dont use links in the history table. These may cause unexpected history changes in future versions.
  \item Name (or short sign) should be visible only internally.
  \item Create a new version after each (also limited) release of the document. Versioning does not depend on the overall document version.
  \item Use the form x.y for the version. x for the master versions, y for the project specific changes and updates.
\end{itemize}

\begin{table}[H]
\caption{History}
\label{tab:gpiohistory01a}
\centering
\begin{tabularx}{\textwidth}{|X |X |X |}
  \hline
  Date & Name & Content Changes \\
  \hline
  \multicolumn{3}{|l|}{Version of this document: V0.1} \\
  \hline
  2025-02-13 & Andreas Siggelkow & First draft (AS) \\
   \hline
  2025-11-19 & Andreas Siggelkow & Changed the BPI; removed the registers from the kernel and added them to GPIOTop. Added an interrupt. Removed the address output. changed the GPIO output to inout. \\
  \hline
  2026-11-06 & Andreas Siggelkow, Claude & Interrupt registers moved to the shared block as\_irq\_peripheral. IRQSC/ISR are write strobes (not stored). IRQSS collects pulses per bit. New register ICR (0x50). RIS[0] is the level |(IRQSS \& IRQSM). \\
  \hline
\end{tabularx}
\end{table}
