asiggel/rwu-rv64iV2.0/RWU_RV/RV_NoPipeline/project.pdf

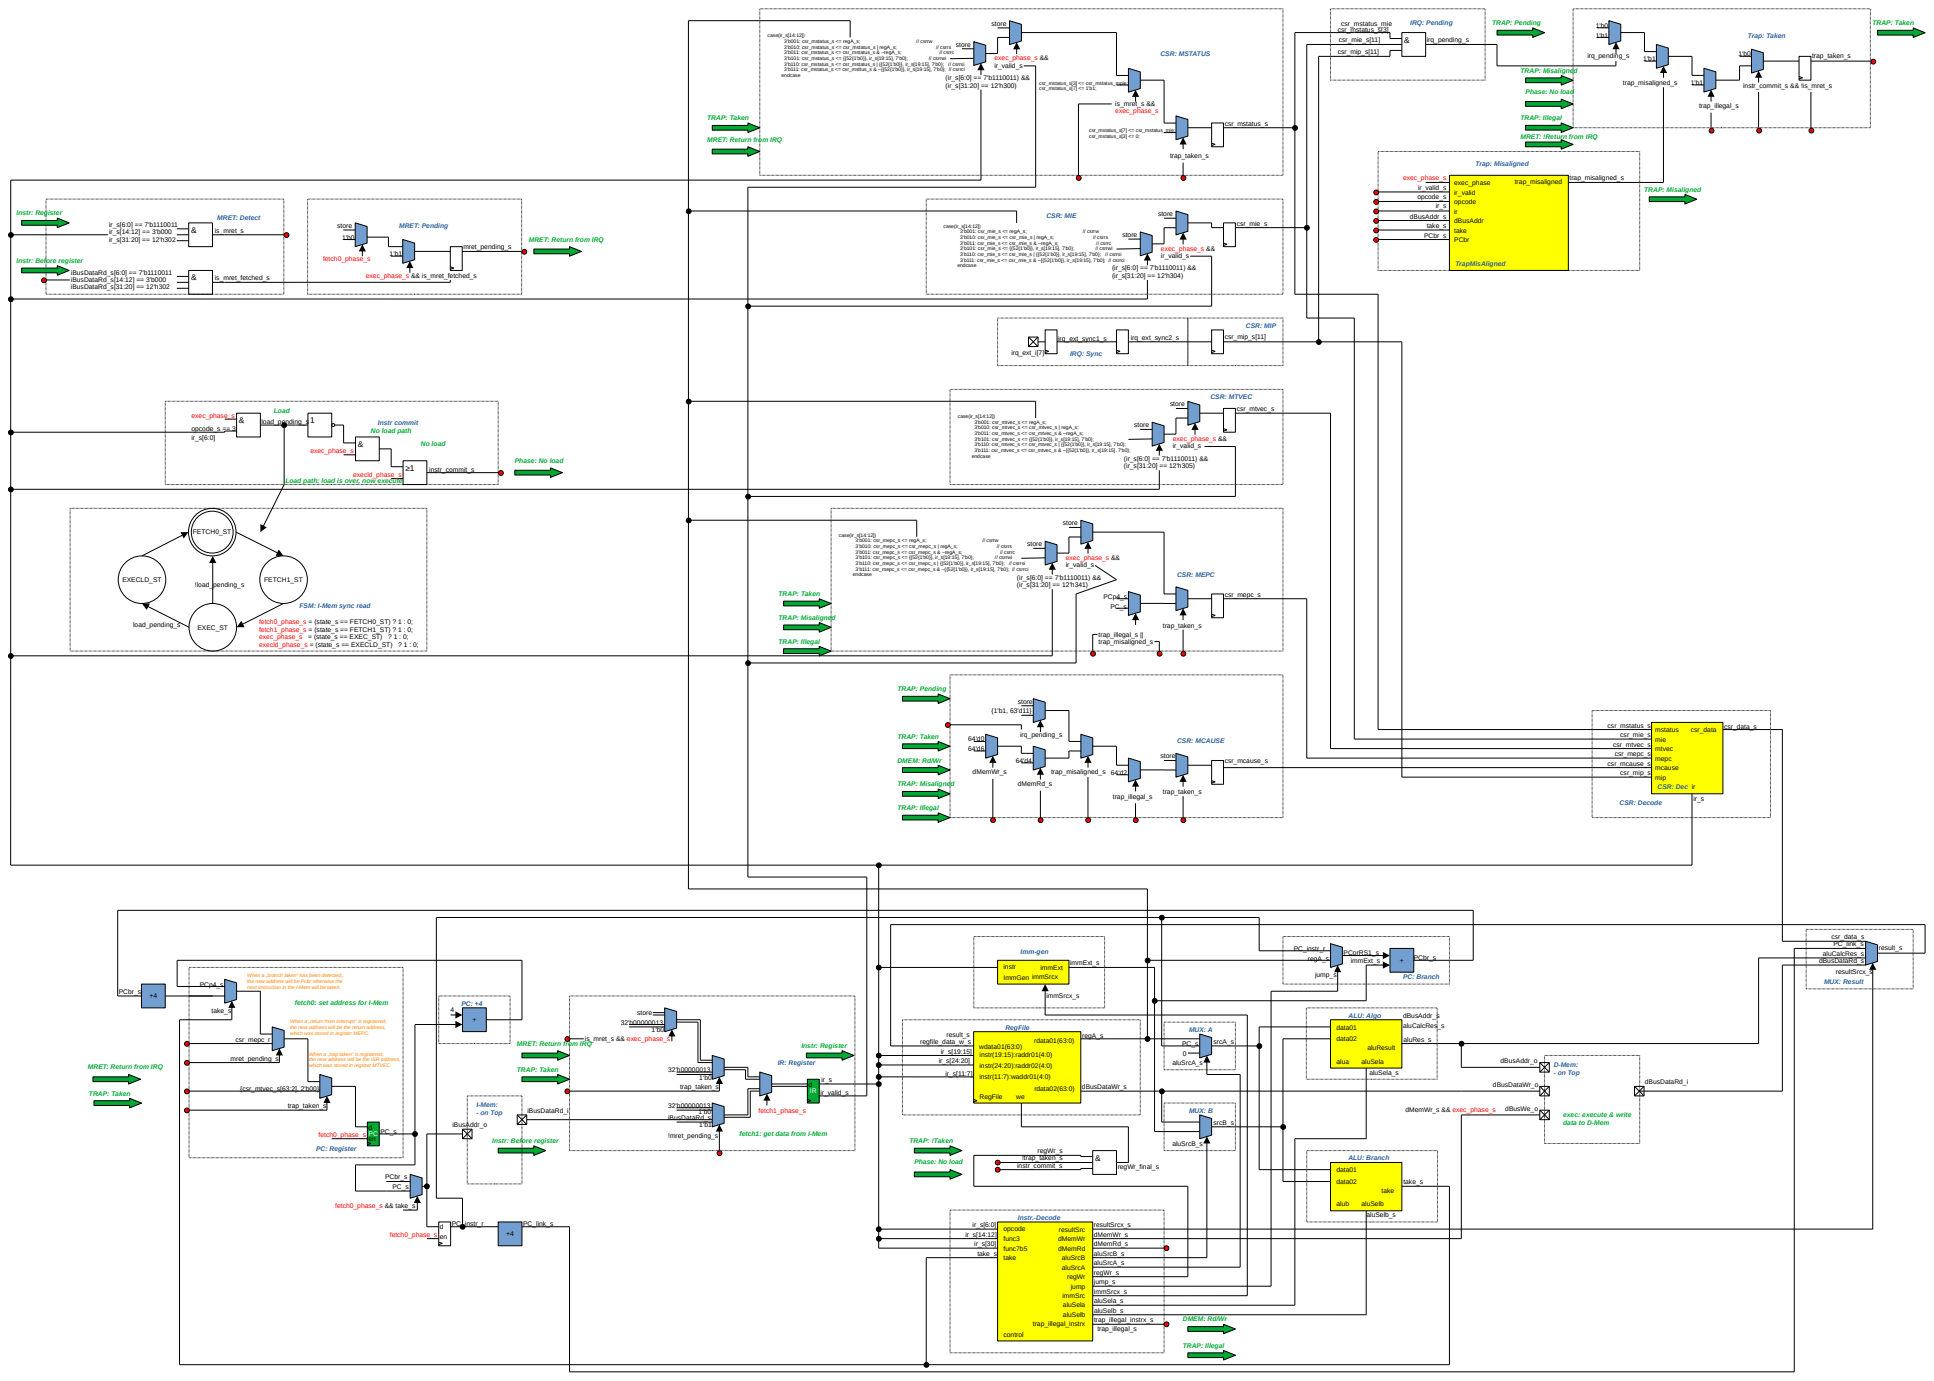
[picture p84: page 1]
regWr_s !trap_taken_s; instr_commit_s; regWr_final_s; dBusAddr_s aluCalcRes_s; irq_ext_i[7]; irq_ext_sync1_s; irq_ext_sync2_s; IRQ: Sync; csr_mip_s[11]; CSR: MIP; !mret_pending_s; iBusDataRd_s; ir_valid_s; fetch1_phase_s; trap_taken_s; is_mret_s && exec_phase_s; store; IR: Register; is_mret_s; is_mret_fetched_s; iBusDataRd_s[6:0] == 7'b1110011 iBusDataRd_s[14:12] == 3'b000 iBusDataRd_s[31:20] == 12'h302; MRET: Detect; FETCH0_ST; FETCH1_ST; EXEC_ST; EXECLD_ST; load_pending_s; !load_pending_s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

Phase: No load

MRET: Return from IRQ

MRET: !Return from IRQ

Instr: Before register

Instr commit
No load path

Load path: load is over, now execute

FSM: I-Mem sync read

csr_mie_s
csr_mtvec_s
csr_mepc_s
csr_mcause_s
csr_mip_s

DMEM: Rd/Wr

When a „branch taken“ has been detected,,
the new address will be Pcbr otherwise the
next instruction in the I-Mem will be taken.

fetch0: set address for I-Mem

When a „return from interrupt“ is registered,
the new address will be the return address,
which was stored in register MEPC.

When a „trap taken“ is registered,
the new address will be the ISR address,
which was stored in register MTVEC.

exec: execute & write
data to D-Mem

fetch1: get data from I-Mem

ir_s[14:12] | dMemWr_s
ir_s[30] | dMemRd_s
take_s | aluSrcB_s

aluSrcA_s
regWr_s
