asiggel/rwu-rv64iV2.0/RWU_RV/RV_NoPipeline/syn/.Xil/as_cpux_propImpl.xdc

set_property SRC_FILE_INFO {cfile:/home/andreas/bwSyncShare/ASWork/AS-Schreibtisch/ProgrammierenX/SystemVerilog/RWU_RV/RV_NoPipeline/syn/Zybo-Master.xdc rfile:../Zybo-Master.xdc id:1} [current_design]
set_property src_info {type:XDC file:1 line:10 export:INPUT save:INPUT read:READ} [current_design]
create_clock -add -name sys_tck_pin -period 800.00 -waveform {0 400} [get_ports { tck_i }];
set_property src_info {type:XDC file:1 line:12 export:INPUT save:INPUT read:READ} [current_design]
set_property CLOCK_DEDICATED_ROUTE FALSE [get_nets tck_i]
set_property src_info {type:XDC file:1 line:14 export:INPUT save:INPUT read:READ} [current_design]
create_generated_clock -name clk_core -source [get_ports {clk_i}] -divide_by 200 -add -master_clock sys_clk_pin [get_pins {cgu/clk_core_o}]
set_property src_info {type:XDC file:1 line:16 export:INPUT save:INPUT read:READ} [current_design]
set_false_path -from [get_clocks sys_clk_pin] -to [get_clocks sys_tck_pin]
set_property src_info {type:XDC file:1 line:17 export:INPUT save:INPUT read:READ} [current_design]
set_false_path -from [get_clocks sys_tck_pin] -to [get_clocks sys_clk_pin]
set_property src_info {type:XDC file:1 line:19 export:INPUT save:INPUT read:READ} [current_design]
set_false_path -from [get_clocks sys_clk_pin] -to [get_clocks clk_core]
set_property src_info {type:XDC file:1 line:20 export:INPUT save:INPUT read:READ} [current_design]
set_false_path -from [get_clocks clk_core] -to [get_clocks sys_clk_pin]
set_property src_info {type:XDC file:1 line:22 export:INPUT save:INPUT read:READ} [current_design]
set_false_path -from [get_clocks sys_tck_pin] -to [get_clocks clk_core]
set_property src_info {type:XDC file:1 line:23 export:INPUT save:INPUT read:READ} [current_design]
set_false_path -from [get_clocks clk_core] -to [get_clocks sys_tck_pin]
set_property src_info {type:XDC file:1 line:113 export:INPUT save:INPUT read:READ} [current_design]
set_property -dict { PACKAGE_PIN W14   IOSTANDARD LVCMOS33 } [get_ports { cs_o }]; #IO_L8P_T1_34 Sch=JC3_P
set_property src_info {type:XDC file:1 line:120 export:INPUT save:INPUT read:READ} [current_design]
set_property -dict { PACKAGE_PIN T14   IOSTANDARD LVCMOS33 } [get_ports { gpio_io[0] }]; #IO_L5P_T0_34 Sch=JD1_P
set_property src_info {type:XDC file:1 line:121 export:INPUT save:INPUT read:READ} [current_design]
set_property -dict { PACKAGE_PIN T15   IOSTANDARD LVCMOS33 } [get_ports { gpio_io[1] }]; #IO_L5N_T0_34 Sch=JD1_N
set_property src_info {type:XDC file:1 line:122 export:INPUT save:INPUT read:READ} [current_design]
set_property -dict { PACKAGE_PIN P14   IOSTANDARD LVCMOS33 } [get_ports { gpio_io[2] }]; #IO_L6P_T0_34 Sch=JD2_P
set_property src_info {type:XDC file:1 line:123 export:INPUT save:INPUT read:READ} [current_design]
set_property -dict { PACKAGE_PIN R14   IOSTANDARD LVCMOS33 } [get_ports { gpio_io[3] }]; #IO_L6N_T0_VREF_34 Sch=JD2_N
set_property src_info {type:XDC file:1 line:124 export:INPUT save:INPUT read:READ} [current_design]
set_property -dict { PACKAGE_PIN U14   IOSTANDARD LVCMOS33 } [get_ports { gpio_io[4] }]; #IO_L11P_T1_SRCC_34 Sch=JD3_P
set_property src_info {type:XDC file:1 line:125 export:INPUT save:INPUT read:READ} [current_design]
set_property -dict { PACKAGE_PIN U15   IOSTANDARD LVCMOS33 } [get_ports { gpio_io[5] }]; #IO_L11N_T1_SRCC_34 Sch=JD3_N
set_property src_info {type:XDC file:1 line:126 export:INPUT save:INPUT read:READ} [current_design]
set_property -dict { PACKAGE_PIN V17   IOSTANDARD LVCMOS33 } [get_ports { gpio_io[6] }]; #IO_L21P_T3_DQS_34 Sch=JD4_P
set_property src_info {type:XDC file:1 line:127 export:INPUT save:INPUT read:READ} [current_design]
set_property -dict { PACKAGE_PIN V18   IOSTANDARD LVCMOS33 } [get_ports { gpio_io[7] }]; #IO_L21N_T3_DQS_34 Sch=JD4_N
set_property src_info {type:XDC file:1 line:131 export:INPUT save:INPUT read:READ} [current_design]
set_property -dict { PACKAGE_PIN V12   IOSTANDARD LVCMOS33 } [get_ports { tck_i }]; #IO_L4P_T0_34 Sch=JE1
set_property src_info {type:XDC file:1 line:132 export:INPUT save:INPUT read:READ} [current_design]
set_property -dict { PACKAGE_PIN W16   IOSTANDARD LVCMOS33 } [get_ports { trst_i }]; #IO_L18N_T2_34 Sch=JE2
set_property src_info {type:XDC file:1 line:133 export:INPUT save:INPUT read:READ} [current_design]
set_property -dict { PACKAGE_PIN J15   IOSTANDARD LVCMOS33 } [get_ports { tms_i }]; #IO_25_35 Sch=JE3
set_property src_info {type:XDC file:1 line:134 export:INPUT save:INPUT read:READ} [current_design]
set_property -dict { PACKAGE_PIN H15   IOSTANDARD LVCMOS33 } [get_ports { tdi_i }]; #IO_L19P_T3_35 Sch=JE4
set_property src_info {type:XDC file:1 line:135 export:INPUT save:INPUT read:READ} [current_design]
set_property -dict { PACKAGE_PIN V13   IOSTANDARD LVCMOS33 } [get_ports { tdo_o }]; #IO_L3N_T0_DQS_34 Sch=JE7
