asiggel/rwu-rv64iV2.0/(commit log)

2026-05-12 Add AXI4 data port to QSPI peripheral (RTL + testbench)
    as_pack.sv: add 32 missing QSPI register offset and reset-value
    constants (qspi_*_reg_addr_offs_c / qspi_*_reg_rst_c) so the
    standalone ip_qspi package compiles without the main project tree.
    asQspiTop.sv (v3): add AXI4 read-only slave port (AR+R channels).
    4-beat 32-byte burst is served by 4 sequential 8-byte kernel
    transactions; results buffered in axi_buf[4], then driven as R beats.
    AXI4 FSM: IDLE→KICK→WAIT→RXPOP→RESP. Kernel addr/len muxed between
    Wishbone registers and AXI4 capture registers. ARREADY blocked while
    kernel is busy from either port.
    asQspiTop_tb.sv (v3): wire all AXI4 port signals, add axi_burst_read
    task, a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
    [asQspiTop.sv, asQspiTop_tb.sv, as_pack.sv]
2026-05-12 Fix asQspiTop_tb for Vivado xsim compatibility
    Replace do-while loops with while loops (xsim rejects do-while in tasks).
    Replace 64'(qspi_id_reg_addr_rst_c) with literal 64'h00000000_00000010
    (constant not visible when Vivado compiles with RWU_RV as_pack.sv).
    [asQspiTop_tb.sv]
2026-05-15 Add QSPI NOR flash interface to RV_NoPipelineCache: replace AXI4 flat ports with physical QSPI pins, add W25Q flash behavioral model in all 10 testbenches; all regression tests pass
    [asQspiTop.sv, asTopMem.sv, tb_rv64i_instr05loadhalfu.sv, tb_rv64i_readgpioid.sv]
2026-05-15 Extract SRAM array from asScratch into as_sram_sp64 sub-module for ASIC swap-out
    asScratch now contains only the controller FSM; as_sram_sp64.sv holds the
    behavioral memory array and documents the X-Fab macro pin mapping. To target
    ASIC, replace as_sram_sp64.sv with an X-Fab wrapper — no other file changes needed.
    [asScratch.sv, as_sram_sp64.sv]
2026-05-17 Tie clk_qspi_s to clk_div_s in asTopMem; wire QSPI ctrl and AXI4 IF to named domain clock
    clk_qspi_s was generated by the CGU but never connected, making it a dead
    signal. Now assigned from clk_div_s (same frequency, no CDC needed yet) so
    the QSPI clock domain is architecturally visible. as_qspi_top and qspi_if_s
    both use clk_qspi_s; swapping in the real CGU output later only requires
    changing the one assign and adding a CDC bridge on the AXI4 interface.
    [asTopMem.sv]
2026-05-17 Cleanup asTopMem: localparam placement, dead signals, stale comment
    - Move localparam QSPI_AW to declaration block (Rule 1)
    - Remove ir_s and three WB ACK signals; leave ports unconnected —
    bridge uses fixed 1-cycle dc_rvalid, ACK is intentionally ignored
    - Fix clk_div_o port comment (was misleadingly "same domain as QSPI master")
    - JTAG im_*/bs_* signals retained: boundary scan and memory scan chain
    (XScale-style) planned for future implementation
    [asTopMem.sv]
2026-05-17 Fix Rule-2 naming: rename registered signals from _s to _r
    asCguCore.sv: cnt1_s–cnt4_s → cnt1_r–cnt4_r (clock divider counters)
    asCPUx.sv (both NoPipeline and NoPipelineCache):
    csr_mepc_s, csr_mcause_s, csr_mtvec_s,
    csr_mstatus_s, csr_mie_s, csr_mip_s → _r suffix
    All signals are driven exclusively by always_ff blocks.
    Regression: 10/10 tests passed.
    [asCPUx.sv, asCguCore.sv]
2026-05-17 Fix Rule-2 naming in ip_uart; Rule-7 compliance in ip_fifo
    ip_uart/br.sv: cnt_s → cnt_r
    ip_uart/rx.sv: data_s, delay_rdy_s, delay_rx_s → _r
    (rdy_s and falling_*_edge_s are combinatorial assigns — _s kept)
    ip_uart/tx.sv: data_s, delay_rdy_s → _r
    (rdy_s and falling_edge_s are combinatorial assigns — _s kept)
    ip_fifo/as_fifo.sv: wrap initial/$fatal parameter checks in
    synthesis translate_off/on — block is elaboration-time only,
    excluded from synthesis without losing the simulation guard.
    Regression: 10/10 passed.
    [as_fifo.sv]
2026-05-19 Immediate mistake in CPU fixed
    [asCPUx.sv, scratchpad_intensive.asm, tb_rv64i_instr05loadhalfu.sv, tb_rv64i_readgpioid.sv, tb_rv64i_scratchpad_intensive.sv]
2026-05-20 Fix dcache_test phase 6 warm-hit check + watchdog
    Phase 6 checked tag10 (0x2800) as a warm hit, but tag10 is evicted in
    phase 5 when tag8 is reloaded (PLRU victim=W2). Replace with tag11 (0x2C00,
    W3) which stays cached throughout. Simulation now shows three clean hits in
    phase 6. Also reduce watchdog from 5s to 2s (5e9 overflows xsim 32-bit).
    [dcache_test.asm, tb_rv64i_dcache_test.sv]
2026-05-20 Add memory_sections test: .text/.rodata/.data/.bss/stack/heap demo
    Demonstrates all six memory regions of the RWU-RV64I Harvard system
    in a single runnable test:
    .text — instructions in Flash, fetched via I-Cache
    .rodata — constants in Flash D-Cache region (0x2000)
    .data — initialised variables, image at Flash LMA 0x3000, copied to
    scratchpad VMA 0x1000 by startup code
    .bss — uninitialised scratchpad storage, zeroed by startup
    stack — LIFO area at scratchpad top (0x1FF8), ABI prologue/epilogue
    heap — bump-allocator demo above .bss (_heap_start = _bss_end)
    Adds memory_sections.ld (GNU ld linker script for the Harvard layout),
    extends rv64Sim/CM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
2026-06-02 Fix JTAG bugs: TRST polarity, TDO edge, IDCODE mux, IR bit-shift
    RTL (ip_jtag/src/):
    - tap_fsm.sv: TRST# active-low per IEEE 1149.1 (~trst_i)
    - jtag.sv: jtag_rst_s uses ~trst_i consistently
    - jtag.sv: TDO driven on falling TCK edge (negedge FF was present
    but bypassed; now active per standard)
    - jtag.sv: IDCODE TDO mux case 1 routes tdo_id_s instead of tdo_by_s
    Testbenches (tb/):
    - trst_s initialised to 1 (deasserted, active-low)
    - jtag_load_ir: dummy clock added after Capture-IR so that the
    Capture->Shift parallel-load slot is absorbed and all 8 IR bits
    are shifted correctly (IR values with bit 7=0 would have failed)
    - instr99scantest*: TDO sample delay raised from 4 to 5*tclk_2_t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
    [jtag.sv, tap_fsm.sv, tb_rv64i_instr99loadimem.sv, tb_rv64i_instr99scantest.sv]
2026-06-02 Fix xsim hang: update TRST# polarity in CPU testbenches after JTAG fix
    The JTAG bug fix (7082c27) introduced active-low TRST# (assign trst_s = ~trst_i)
    per IEEE 1149.1. All CPU testbenches that don't exercise JTAG were left with
    trst_i=1, which now means TRST# deasserted — no TAP FSM reset. In xsim, state_s
    starts as X, propagating to dr_cap_s=X and clk_div_s=X, so the CPU never runs
    and the simulation loops forever waiting for cs_s===1.
    Fix: set trst_i=0 (TRST# asserted) in all 10 non-JTAG CPU testbenches, which
    holds the TAP FSM in reset_st, giving dr_cap_s=0 and clk_div_s=clk_core_s.
    Testbenches with free-running TCK and jtag_sw_rst (scantest, loadimem) are
    unaffected — they recover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
    [tb_rv64i_instr05loadhalfu.sv, tb_rv64i_readgpioid.sv]
2026-06-02 Consolidate 9 instruction testbenches into tb_rv64i_instr.sv
    Replace the 9 per-instruction testbenches (instr01..instr29) with a single
    tb_rv64i_instr.sv that is configured at runtime via plusargs:
    +TEST_NAME=<label> written to error.txt
    +EXPECTED=<int> GPIO value that signals test success
    CMakeLists.txt maps each test to its name/expected value and passes them
    as -DTB_TEST_NAME / -DTB_EXPECTED into sim/CMakeLists.txt, which forwards
    them as --testplusarg (xsim) or command-line plusargs (Verilator).
    A cs_count >= 20 guard prevents infinite hangs if the expected value
    never appears. Both xsim and Verilator regressions pass unchanged.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
    [tb_rv64i_instr.sv, tb_rv64i_instr05loadhalfu.sv]
2026-06-03 Fix branch/jump control flow; add CSR rd-write and CSRi imm fix; extend regression to 57 tests
    RTL fixes (asCPUx.sv, asInstrDecode.sv, asAluBr.sv, as_pack.sv):
    - Add PC_instr_r register capturing the fetch address at each FETCH0_ST; use it
    as branch-target base and for AUIPC, eliminating the off-by-4 error caused by
    PC_s being one slot ahead of the instruction in IR.
    - Redirect iBusAddr_s to PCbr_s during FETCH0_ST when take_s=1, so I-Mem
    delivers the branch-target instruction in FETCH1_ST without a pipeline bubble.
    - Advance PC_s to PCbr_s+4 on taken branch/jump to preserve the invariant
    PC_s = instr_addr+4 and prevent double-execution of the first target instruction.
    - Add BR_ALWAY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
    [asAluBr.sv, asCPUx.sv, asInstrDecode.sv, as_pack.sv, instr06addi.asm, instr08slti.asm, instr09sltiu.asm, instr10xori.asm]
2026-06-03 Add FENCE instruction as legal no-op; regression now 58 tests
    as_pack.sv: add OP_FENCE = 7'b0001111 to opcode_t enum.
    asInstrDecode.sv: decode OP_FENCE as a no-op (all outputs stay at
    default) so the illegal-instruction flag is not raised. A
    single-issue CPU with no cache has total memory order already, so
    no microarchitectural action is required.
    instr58fence.asm: verify fence does not trap and that stores before
    and after the barrier reach GPIO in program order.
    All 58 regression tests pass.
    [asInstrDecode.sv, as_pack.sv, instr58fence.asm]
2026-06-03 Add cocotb PoC: Verilator + cocotb smoke test for as_top_mem
    New directory RWU_RV/RV_NoPipeline/cocotb/ parallel to sim/.
    Makefile: builds with Verilator 5.x + cocotb 2.0.1 (local venv);
    copies the chosen MEMFILE to riscvtest.mem in CWD so asIMem.sv's
    $readmemh("riscvtest.mem") finds it at simulation start.
    test_poc.py: drives clk/rst, detects rising edges of cs_o (GPIO chip-
    select), reads dut.asGpio.data_reg_s for the GPIO byte value, and
    asserts it matches +expected. Rising-edge detection is needed because
    cs_o stays high for ~80 fast-clock cycles (CGU divides clk_i by 80).
    programs/instr06addi.mem: pre-assembled instr06addi test; produces four
    GPIO writes ending with 0xFF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
2026-06-03 cocotb compliance suite + 3 RTL fixes found by ISS scoreboard
    ISS scoreboard (iss.py):
    Full RV64I + Zicsr + MRET reference model. On every instr_commit_s
    rising edge the scoreboard compares DUT.PC_instr_r with ISS.pc and,
    when regWr_final_s=1, the register write (rd, value) — catching bugs
    that do not change the final GPIO output.
    Bugs found and fixed:
    1. asAlu.sv SRAW/SRAIW: $signed() was wrapping the whole expression
    including >>>, so >>> saw an unsigned operand and performed a logical
    (zero-filling) shift instead of arithmetic. Fix: move $signed()
    to wrap only the operand.
    ISS report: ISS x5←0xffd5 vs DUT x5←0x00ffffffd5 (upper 32 zero).
    2. asCPUx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
    [asAlu.sv, asCPUx.sv, iss.py, test_regression.py]
2026-06-03 Sync RV_NoPipelineCache: fix CSRi immediate encoding in asCPUx.sv
    Port the CSRi fix from RV_NoPipeline (commit ed59ab2):
    {{52{1'b0}}, ir_s[19:15], 7'b0} → {{59{1'b0}}, ir_s[19:15]}
    for all 12 occurrences (csrrwi/csrrsi/csrrci on mie, mstatus, mepc, mtvec).
    All other fixes (PC_fetch_r branch-target base, branch-redirect of
    ic_addr_s, PC_s<=PCbr_s+4, PC_fetch_r+4 link address, SRAW $signed fix,
    BR_ALWAYS for JAL/JALR, en_regWr_o for CSR) were already present in the
    Cache version or are inherited via the shared NP_ROOT source path.
    RV_NoPipelineCache regression: 26/26 tests pass.
    [asCPUx.sv]
2026-06-03 RV_NoPipelineCache: unify instruction TBs — single tb_rv64i_instr.sv
    All 58 RV64I instruction tests now use tb_rv64i_instr.sv (with QSPI
    flash model) via +TEST_NAME / +EXPECTED plusargs, matching the
    RV_NoPipeline approach. The 9 per-instruction TBs (instr01–instr07,
    instr19, instr29) that were superseded by the unified TB are removed.
    Specialized tests (readgpioid, dcache_test, memory_sections,
    scratchpad_intensive) retain their own TBs.
2026-06-03 RV_NoPipelineCache: Verilator regression, fix test ordering & xsim cfg
    - CMakeLists: add sequential dependency chain (each sim_* waits for
    the previous) so tests run in list order, cache-specific tests last
    - sim/CMakeLists: simulate target uses xsim_cfg_reg.tcl (no log_wave)
    to avoid multi-GB wdb files during regression; waves target keeps
    xsim_cfg.tcl with full signal recording
    - RV_NoPipeline/sim/xsim_cfg_reg.tcl: new minimal TCL batch script
    (run all + exit, no log_wave) shared by both projects
    Regression: 62/62 tests pass with Verilator (xsim incompatible with
    QSPI flash model in TB — automatic variables in always blocks).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
2026-06-03 RV_NoPipelineCache: fix xsim TB — TRST# polarity + task automatic flash model
    Two xsim-specific bugs in all 5 RV_NoPipelineCache testbenches:
    1. trst_s <= 1 left JTAG TAP unreset; dr_cap_s = X in 4-state sim →
    clk_div_s = X → CPU clock never toggled → all tests hit watchdog
    Fix: trst_s <= 0 (TRST# active-low, assert reset, dr_cap_s = 0)
    2. QSPI flash model used automatic vars inside always block (xsim rejects
    nested event controls with inline automatic vars)
    Fix: moved to task automatic flash_transaction() with return
    [tb_rv64i_dcache_test.sv, tb_rv64i_instr.sv, tb_rv64i_memory_sections.sv, tb_rv64i_readgpioid.sv, tb_rv64i_scratchpad_intensive.sv]
2026-06-04 RTL cleanup: Verilator warnings, two RTL bugs, FPGA ram_style
    Verilator warning fixes (synthesizable files only):
    - SYNCASYNCNET: as_fifo, asDCache, asICache → async reset added to sensitivity list
    - WIDTHEXPAND: as_fifo (CNT_WIDTH cast), asDCache merge_write (concat replaces ADD)
    - UNSIGNED: asMemTop SP_BASE=0 lower-bound comparison (lint_off/on)
    - PINNOCONNECT: asCPUx sc03/sc04 positional → named port connections
    - UNUSEDSIGNAL: dead signals removed (rd_s in asCguTop/asGpioTop, clk_bus signals
    in asTopMem); inline lint_off for interface-compat ports and arch-in-progress signals
    - UNUSEDPARAM: PA_WIDTH removed from asScratch + asMemTop instantiation;
    legacy flat-SRAM params in as_pa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
    [asAlu.sv, asCPUx.sv, asCguTop.sv, asDCache.sv, asGpioTop.sv, asICache.sv, asInstrDecode.sv, asMemTop.sv]
2026-06-05 ip_uart_v2: new configurable UART peripheral with spec, RTL and TB
    Spec (RV_NoPipeline/spec/05_uart/):
    - New UART chapter in the specification following GPIO/QSPI structure
    - Requirements subsection with IEEE 29148 tables (FR/BR/TX/RX/FI/ER/IR/SW/HW)
    - 12-register memory map with full bit-field descriptions
    - LaTeX macros and path added to 00_rwurv64i_top.tex
    RTL (ip_uart_v2/src/as_uart_top.sv):
    - Wishbone B4 Classic slave (as_slave_bpi), 12 registers at 8-byte offsets
    - Configurable: 5-8 data bits, even/odd/none parity, 1/2 stop bits, CLKDIV
    - TX/RX FIFOs (as_fifo, parameterised depth), programmable RX threshold
    - 2-FF RX synchroniser, 16x oversampling, loopback, break generation
    - 7 inter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
2026-06-05 RV_NoPipeline: integrate UART0 (ip_uart_v2) into system
    Address map (as_pack.sv + asDecode.sv):
    - chipsel 4 → 5 (one-hot: DMem / GPIO / QSPI / CGU / UART0)
    - UART0: 0x0000_0001_0000_0600 – 0x0000_0001_0000_07FF (512 B)
    lower 8 bits of base = 0x00 → UART_ADDR_WIDTH=8 comparisons are plain offsets
    asTopMem.sv:
    - New ports uart0_tx_o / uart0_rx_i
    - as_uart_top instantiation (FIFO_DEPTH=16, 115200 Bd reset)
    - IRQ[6] = uart0 IRQ (IRQ[7] stays GPIO)
    - wdbAckAll_s includes wdbAckUart_s
    - Data mux uses explicit 5-bit one-hot constants
    Testbenches (all 9 tb_rv64i_*.sv):
    - Added .uart0_tx_o() / .uart0_rx_i(1'b1) to as_top_mem instantiation
    Build system:
    - sim/CMakeLists.txt: as_fifo.sv + as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
    [asDecode.sv, asTopMem.sv, as_pack.sv, tb_rv64i.sv, tb_rv64i_allinstructions.sv, tb_rv64i_filldmem.sv, tb_rv64i_instr.sv, tb_rv64i_instr99loadimem.sv]
2026-06-05 RV_NoPipelineCache: integrate UART0 + spec memory map
    Spec (RV_NoPipeline/spec/):
    - Chapter "Memory Map and Registers" filled in:
    System memory map table (5 entries: DMem, GPIO0, QSPI0, CGU, UART0)
    UART0 register offset table (12 registers, offsets 0x00–0x58)
    Interrupt map table (IRQ[7]=GPIO, IRQ[6]=QSPI, IRQ[5]=UART0)
    - Added \asqspiIRQ macro to 00_rwurv64i_top.tex
    - LaTeX compiles without errors
    RV_NoPipelineCache/src/asTopMem.sv:
    - as_uart_top instantiation (cs[4], FIFO_DEPTH=16, UART0_AW=8)
    - Peripheral mux updated to 5-bit one-hot constants
    - wbdstbUart_s = is_periph_req_s & csx_s[4]
    - IRQ[5] = irq_uart_s (IRQ[6] = QSPI stays, IRQ[7] = GPIO s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
    [asTopMem.sv, tb_rv64i_dcache_test.sv, tb_rv64i_instr.sv, tb_rv64i_memory_sections.sv, tb_rv64i_readgpioid.sv, tb_rv64i_scratchpad_intensive.sv]
2026-06-05 UART TX/RX tests + ip_uart_v2 RX FIFO pop fix
    Add firmware, testbenches and CMake targets for UART0 TX/RX verification in
    both RV_NoPipeline and RV_NoPipelineCache. Simultaneously fix a bug in
    ip_uart_v2 where the RX FIFO was popped one cycle too early.
    Bug (ip_uart_v2/as_uart_top.sv): the non-pipelined CPU uses a 2-cycle load
    (EXEC_ST + EXECLD_ST); data is captured in EXECLD_ST. The show-ahead RX FIFO
    pop was triggered by rd_data_s in EXEC_ST, leaving DATA=0 when the CPU reads
    it one cycle later. Fix: replace rd_data_s with rd_data_r (rd_data_s delayed
    1 clock) as the FIFO rd_en_i so the pop aligns with EXECLD_ST.
    All four uart_tx / uart_rx simulations pass (NoPipeline and NoPipelineCa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
    [Zybo-Master.xdc, as_uart_top.sv, tb_rv64i_uart_rx.sv, tb_rv64i_uart_tx.sv, uart_rx.asm, uart_tx.asm]
2026-06-13 Add pipeline designs, ICU dummy, rst fix, Guideline 8
    - RV_PipelineCache: new design (5-stage pipeline, cache, no forwarding)
    - RV_PipelineCacheFwd: new design (5-stage pipeline, cache, EX/MEM+MEM/WB forwarding)
    - asTopMem (PipelineCacheFwd): dummy ICU with student-task placeholder
    - cc_cpupipefwd: replace !rst_i in start_fetch_s with rst_deasserted_r (Guideline 8)
    - CLAUDE.md: add Guideline 8 (rst/clk only on FF pins)
    - .gitignore: add build_vlt/, syn/, regression.txt, xxxxas*
    - RV_NoPipeline: spec and source updates
    [RWU_RV64I_Cache_Analysis.xlsx]
2026-06-13 RV_PipelineCacheFwd: remove irq_external_s vector, use irq_combined_s
    The dummy ICU produces a single combined interrupt line; the 8-bit
    intermediate vector was redundant. irq_combined_s connects directly to
    the CPU's irq_ext_i MSB via bit-concatenation.
2026-06-13 RV_PipelineCacheFwd: add pipeline hazard test suite (68/68 pass)
    Five new ASM tests covering all pipeline hazard classes, plus a
    statistics testbench that reports CPU-clock cycle counts and CPI
    from reset-deassertion to the final GPIO write.
    Hazard tests (ASM in RV_NoPipeline/rv64Sim/, TB in RV_PipelineCacheFwd/tb/):
    hazard_raw_alu — ALU→ALU RAW at k=1 (EX/MEM→EX), k=2 (MEM/WB→EX),
    k=3 (regfile WBR); no stalls expected
    hazard_raw_load — 3× load-use RAW; each forces a 1-cycle pipeline stall
    hazard_waw_war — WAW (second write wins) and WAR (read sees old value);
    both transparent in the in-order pipeline
    hazard_ctrl_branc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
    [hazard_ctrl_branch.asm, hazard_ctrl_jump.asm, hazard_raw_alu.asm, hazard_raw_load.asm, hazard_waw_war.asm, tb_rv64i_hazard_stat.sv]
2026-07-11 Add X-FAB Cadence design flow HowTo
    Consolidates search notes and mobile AI dictation notes into a structured
    guide covering simulation, synthesis, X-FAB PDK/memory compiler access,
    and the full RTL-to-tapeout flow (core-level and chip-level with pads).
    Claude-Session: https://claude.ai/code/session_01T95KG4bZAywMSg8uYNuyTV
2026-07-11 Add Genus/Xcelium scripts for RV_NoPipeline X-FAB flow
    00_rv64_elab.tcl: collect RTL and elaborate as_top_mem (xh035), file
    order verified against the last successful xsim compile (tb/xvlog.log).
    01a_rv64_sim.tcl: xrun RTL simulation wrapper, batch by default with a
    commented GUI variant for use at the Cadence workstation.
    01b_rv64_syn.tcl: Genus synthesis from the 00_ elaboration checkpoint,
    with placeholder timing constraints and reports.
    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
2026-07-13 RV_NoPipeline: implement ECALL/EBREAK exceptions
    ECALL/EBREAK previously decoded as generic OP_SYSTEM instructions and
    fell through as silent no-ops (README_XFAB.txt finding #5), blocking
    riscv-arch-test compliance and any GDB-stub breakpoint support.
    asCPUx.sv:
    - is_ecall_s/is_ebreak_s detection, wired into mepc/mcause/mstatus like
    the existing illegal-instruction/misaligned traps.
    - mepc now sources from PC_instr_r instead of PC_s for all synchronous
    exceptions (illegal/misaligned/ecall/ebreak): PC_s is one pipeline
    slot ahead by the time the trap is taken, so the old code pointed
    mepc past the faulting instruction.
    - ecbrk_pending_s: ECALL/EBREAK redirect to mtvec one cycle early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
2026-07-13 RV_PipelineCacheFwd: implement ECALL/EBREAK, fix flush/stall priority race
    cc_cpupipefwd.sv:
    - wb_is_ecall_s/wb_is_ebreak_s, wired straight into the existing
    wb_trap_taken_s/mepc/mcause path used by illegal-instruction and
    misaligned traps. No early-redirect trick is needed here (unlike
    RV_NoPipeline): this design's I-cache uses a real req/rvalid
    handshake instead of an always-ack prefetch, so the ordinary
    commit-stage flush is sufficient.
    - Fixed a real, previously-hidden pipeline bug found while verifying
    the above with a new cycle-accurate ISS scoreboard: the id_ex and
    ex_mem pipeline registers only processed flush_s-driven squashing
    inside `else if (!global_stall_s)`. Wh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
2026-07-14 RV_NoPipeline: document ecall/ebreak exceptions in spec
    Adds ecall/ebreak (mcause 11/3) to the Interrupt Concept section, covering
    both chip variants: mepc/mstatus trap-entry semantics, updated trap
    priority, and the as_cpux-specific one-cycle-early mtvec redirect vs.
    cc_cpupipefwd's ordinary commit-stage flush.
    Claude-Session: https://claude.ai/code/session_01Kpiuwasn3ZKjLBoxvfZQTX
2026-07-14 Add ICU (Interrupt Control Unit) peripheral, integrate into both chips
    New reference implementation replacing the RV_PipelineCacheFwd "dummy ICU"
    OR-combine placeholder and RV_NoPipeline's direct (partially dead: UART0
    was wired to a bit the CPU never reads) GPIO/UART interrupt wiring.
    ip_icu/src/cc_icu.sv + cc_icu_top.sv: Wishbone peripheral, 8 source slots
    (GPIO0, UART0, QSPI0, 2 requested spares, 3 further reserved), edge-
    triggered sticky pending (RIS/IMSC/MIS/ICR/ISR, same convention as GPIO0/
    UART0) with SET-priority-over-CLEAR on same-cycle coincidence, software-
    configurable per-source priority + a global-enable bit, and an IRQID cause
    register so firmware no longer has to poll ever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
2026-07-14 RV_NoPipeline: spec updates, X-FAB memory-compiler notes, UART baud fix
    Pre-existing work-in-progress checkpointed as-is (not authored in this
    session): product/architecture/peripheral spec text passes across GPIO,
    memory concept, bus concept, QSPI and UART sections; a Clock Concept spec
    section; X-FAB memory-compiler notes appended to README_XFAB.txt; a
    pre-tapeout review checklist (First_TO_Check.txt); UART0's reset CLKDIV
    corrected to 8 (~9600 baud @ 1.25 MHz clk_core_s, previously computed for
    a 125 MHz clock that is no longer the core clock).
    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
2026-07-14 Add ICU0 requirements to the top-level Requirements chapter (IEEE 29148)
    New 01_requirements_tab02.tex: 22 atomic, individually-verifiable ICU0
    requirements (ICU-SR/PR/MA/PE/ID/SW/HW-xxx) in a longtable with
    Requirement/ID/Importance/Verifiable/Description/Remarks columns, grouped
    by category, cross-referencing the identically-numbered requirements in
    the ICU0 peripheral section (05_icu/05_icu_all.tex, Section 6.5) and the
    full traceability record in ip_icu/README_REQ.txt.
    PDF rebuilt (3x pdflatex for longtable width + forward-reference
    convergence), zero warnings on the final pass.
    Claude-Session: https://claude.ai/code/session_01Kpi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
2026-07-14 RV_PipelineCacheFwd: wire AXI4 I-Cache/D-Cache errors into real traps
    The spec had long claimed AXI4 RRESP!=OKAY errors were surfaced as
    mcause=1 (I-Cache) / mcause=5 (D-Cache), "[RESOLVED]" -- untrue: the
    cache-level ERR_ST/ic_err/dc_err machinery existed and was already
    unit-tested (ip_icache/ip_dcache tb TC07/TC10/TC11), but asTopMem.sv
    hardwired dcpu_if_s.dc_err to 0 and cc_cpupipefwd.sv never read
    icpu_if.ic_err/dcpu_if.dc_err at all -- a real flash/AXI4 fault would
    silently return stale or garbage data instead of trapping.
    asTopMem.sv: forward the real D-Cache dc_err from asMemTop instead of
    tying it to 0.
    cc_cpupipefwd.sv: thread a fault flag through the same per-instruction
    pipelin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
2026-07-14 RV_PipelineCacheFwd: fix stale spec sections, document hazards/bugfix
    Audit of RV_PipelineCacheFwd-specific spec content against current RTL/
    tests found five issues, all fixed here except the AXI4 exception-mapping
    RTL gap (fixed in the preceding commit, this commit updates the text to
    match):
    - 03_arch_memory_concept.tex: MEM-06 falsely claimed "[RESOLVED]" for the
    full AXI4-error-to-mcause path when only the cache-level half existed;
    corrected to describe the now-real end-to-end implementation (mepc/
    mtval sourcing, the fault-flag pipeline threading, the deliberate
    D-Cache-store-errors-out-of-scope limitation).
    - 05_qspi_all.tex: QSPI0_CTRL bitfield table had RX_FLUSH/TX_FLUSH at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
2026-07-14 Instruction Decoder (5.2): rewrite spec to match current as_instr_decode.sv
    The whole section documented a retired port set (opcode_i/aluSel_o/
    PCSrc_o/zero_i/branch_s_o/jump_s_o) that no longer exists on the real
    module, and never mentioned trap_illegal_instr_o -- the decoder's sole
    exception-request output (illegal-instruction trap, mcause=2) -- at all:
    "Service Requests" said "None.", the HW-interfaces table's Interrupt row
    was empty, and it did not appear in the I/O table either.
    04_dec_tab01.tex: fixed a copy-paste header ("Generic GPIO Feature Set")
    and added a trap_illegal_instr_o feature row.
    04_dec_text06.tex: added the two previously-missing opcodes (FENCE=15,
    SYSTEM=115) to the f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
2026-11-06 Shared IRQ register block as_irq_peripheral for GPIO and UART
    New ip_irqper/src/as_irq_peripheral.sv implements RIS/IMSC/MIS/ICR/ISR
    and, with irqs_yes_no=1, IRQSS/IRQSM/IRQSC for groups of same-type IRQs.
    ICR, ISR and IRQSC are write-1 strobes (not stored, read 0); RIS and
    IRQSS are sticky with set-wins-over-clear; RIS[0] of a group is the
    level |(IRQSS & IRQSM), so IRQSC alone clears a GPIO interrupt.
    - asGpioTop: own IRQ logic replaced by instance gpioIrq (irqs_yes_no=1);
    new GPIO0_ICR at offset 0x50 (gpio_icr_reg_addr_offs_c)
    - as_uart_top: RIS/IMSC/MIS/ICR replaced by instance u_irq
    (irqs_yes_no=0); new UART0_ISR at offset 0x60
    - source lists (CMake, cocotb Makefiles, tcl, sim Make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
2026-11-06 as_pack: remove unused GPIO IRQ reset constants
    gpio_irqss/irqsc/isr/ris/mis_reg_rst_c became unused when asGpioTop
    switched to as_irq_peripheral (ICR/ISR/IRQSC are strobes, RIS/MIS have
    fixed reset 0). gpio_irqsm_reg_rst_c and gpio_imsc_reg_rst_c stay.
    Verified: readgpioid and uart_rx pass in xsim on RV_NoPipeline and
    RV_PipelineCacheFwd.
2026-11-06 ip_qspi: remove unused as_pack.sv copy
    Neither the CMake flow (ip_qspi/CMakeLists.txt) nor the Vivado project
    (sim/project_1) uses this copy; both compile
    RWU_RV/RV_NoPipeline/src/as_pack.sv. The copy was stale (int-typed
    constants, old UART base address 0x120).
2026-11-12 ToolChain slides; regression report flags missing error.txt
    Add the SoC1&2 tool chain lecture deck (ToolChain/): installation,
    project layout, single test case with Verilator and with xsim,
    regression and common pitfalls.
    collect_errors.cmake: a test without error.txt was reported as
    "(no errors)", which reads like a pass although the test never
    reported. Print "MISSING error.txt - test did not report (treat as
    fail)" instead.
